rixnobis/ps1-fx3-cart/schematic.pdf

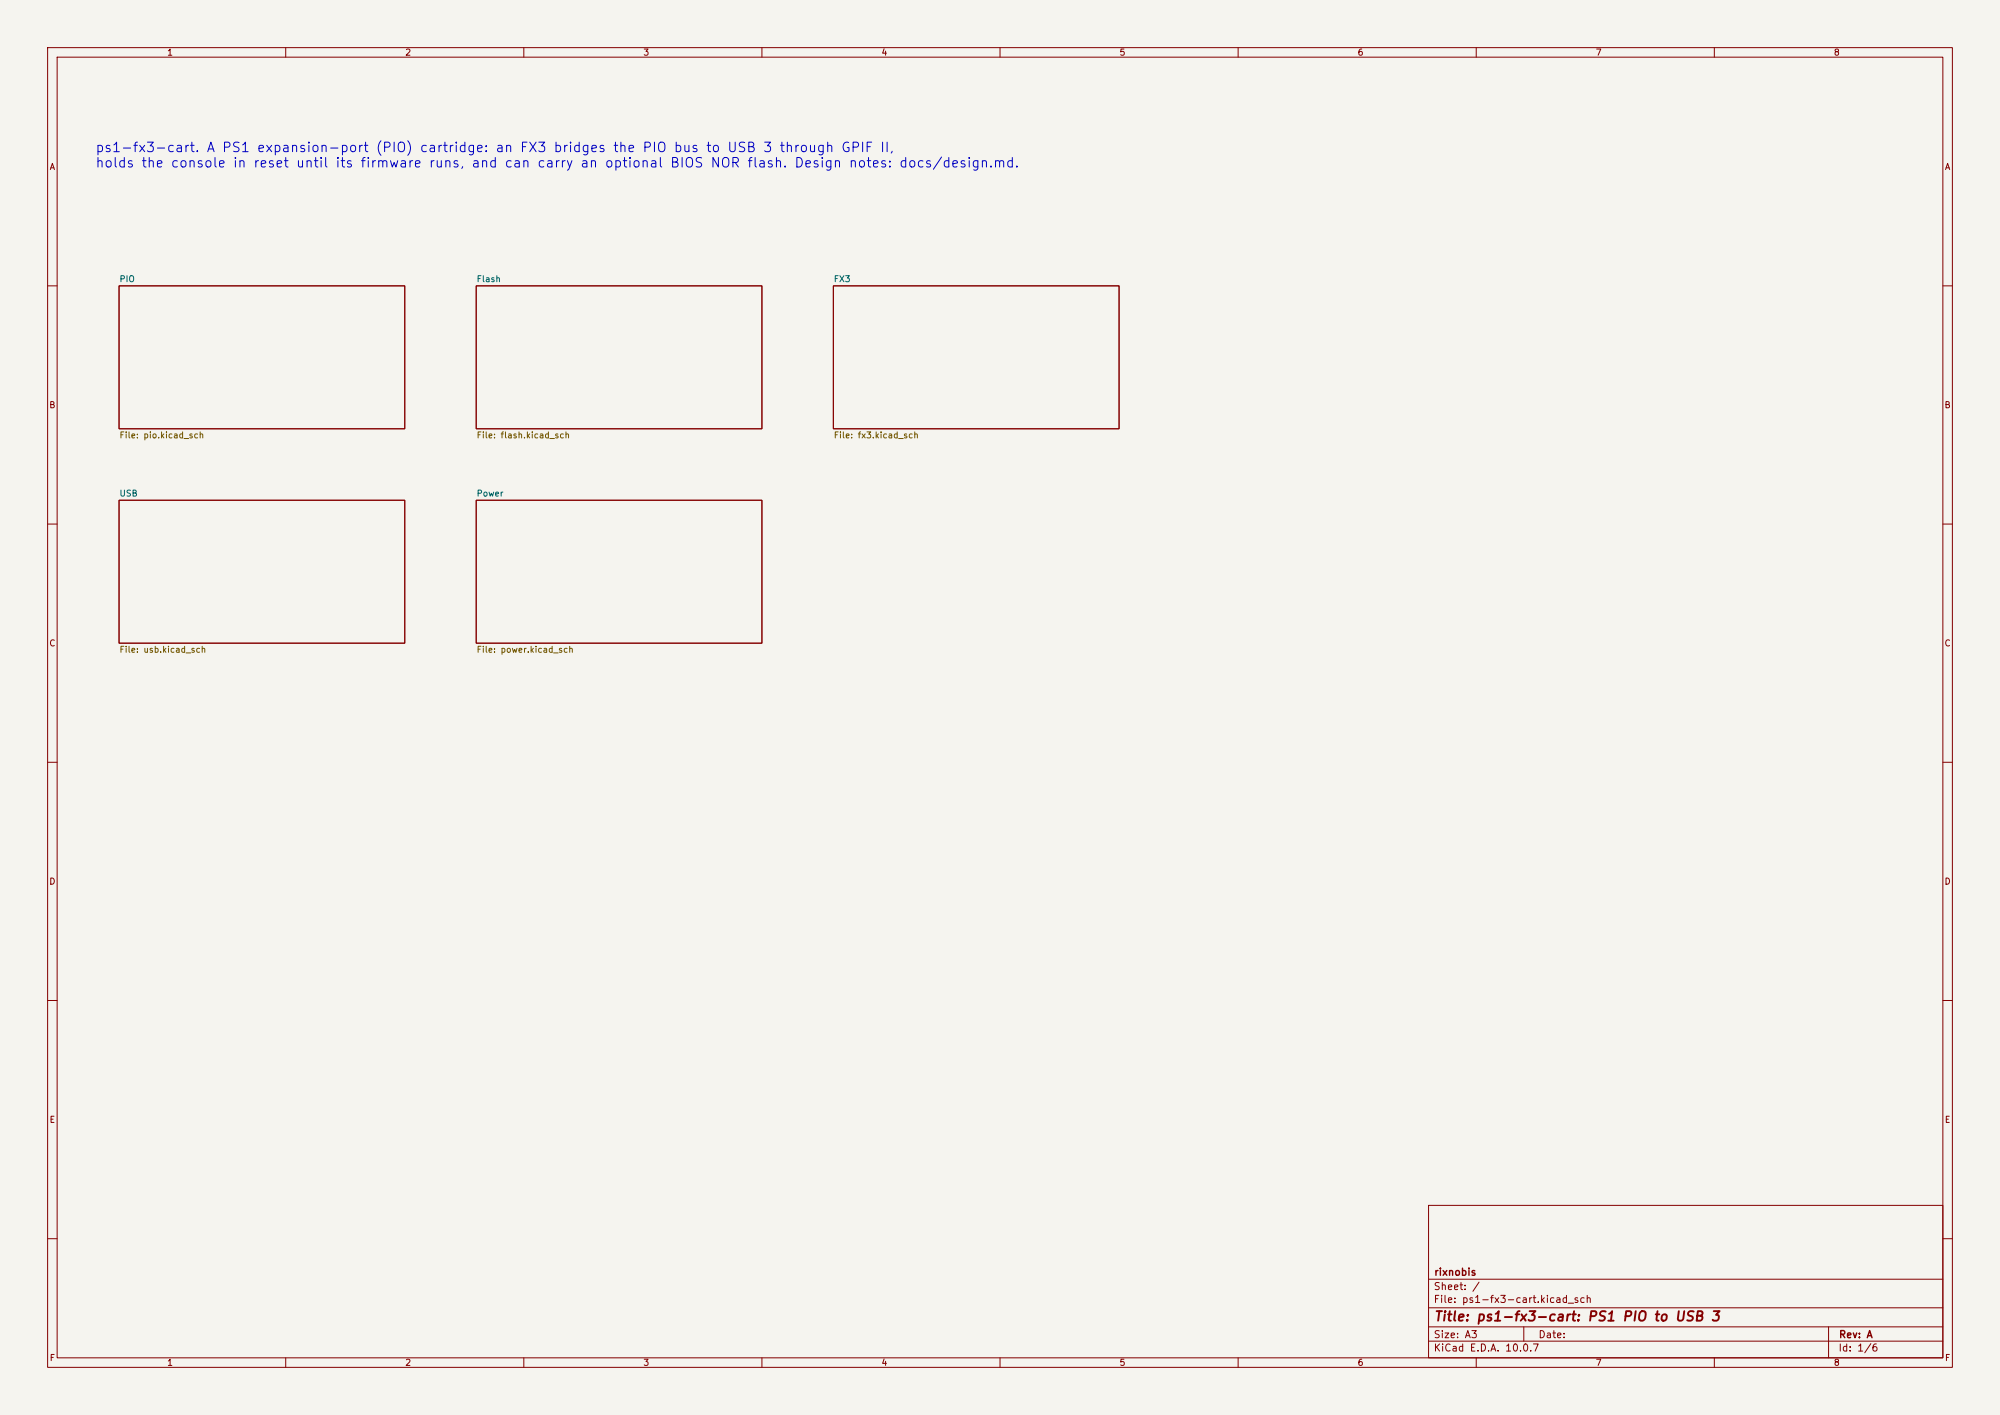
[picture p1: page 1]

ps1-fx3-cart. A PS1 expansion-port (PIO) cartridge: an FX3 bridges the PIO bus to USB 3 through GPIF II,
holds the console in reset until its firmware runs, and can carry an optional BIOS NOR flash. Design notes: docs/design.md.

rixnobis
Sheet: /
File: ps1-fx3-cart.kicad_sch
Title: ps1-fx3-cart: PS1 PIO to USB 3

Size: A3 | Rev: A | F Date:
KiCad E.D.A. 10.0.7 | Id: 1/6

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
## Title: PIO connector, reset hold, defaults

File: pio.kicad_sch

Sheet: /PIO/

rixnobis

GND 1 | RESET 2 | DREQ5 3 | CS0 4
SBEN 5 | D0 6 | D2 7 | D4 8 | D6 9 | D8 10 | D10 11 | D12 12 | D14 13

A0 14
A2 15 | GND 16 | +3.3V 17 | +7.5V 18 | GND 19

A4 20
A6 21
A8 22
A10 23
A12 24
A14 25
A16 26
A18 27
A20 28
A22 29 RD 30

IRQ2 31

SYSCLK1 32 | BCLK 33 | GND 34 | GND | 35 DACK5 | 36
IRQ10 | 37 WR1 | 38 CS2 | 39 D1 | 40 D3 | 41 D5 | 42 D7 | 43 D9 | 44 D11 | 45 D13 | 46 D15 | 47
A1 | | | | | 48
A3 | 49 GND | 50 +3.3V | 51 +7.5V | 52 GND | 53
A5 | | | 54
A7 | | | 55
A9 | | | 56
A11 | | | 57
A13 | | | 58
A15 | | | 59
A17 | | | 60
A19 | | | 61
A21 | | | 62
A23 | 63 WR0 | 64 CS5 | 65
LRCK | | 66
SDIN | 67 GND | 68

### J1PIO

R1
1 | 1k 2 3 | Q1
2N7002 | R2
1k R4

1k R3
1kR5
10k | R7
10k | R8

10k R6
10k
PIO_A2 | PIO_A13 PIO_A11 PIO_A9 PIO_A7 GND

GND

PIO_A5 GND

PIO_I2S_LRCK

# PIO_CS5n PIO_WR0n PIO_WR1n GND

PIO_A0 | PIO_D9 PIO_D1 PIO_D7 PIO_D5 PIO_D8 PIO_D6 PIO_D4 PIO_D2 PIO_D0 | PIO_D3 | PIO_SBEN PIO_IN2n | PIO_DREQ5 GND +3V3 GND | +3V3 PIO_SBEN | PIO_INT10n PIO_CS2n_SENSE PIO_CS2n | GND | PIO_SBEN_DRV
PIO_A15 | RST_SENSE GND | +3V3 RST_HOLD | PIO_RESETn PIO_RESETn RST_HOLD
PIO_RESETn | PIO_DACK5 PIO_I2S_SDIN

PIO_A19 PIO_A17 PIO_A8 PIO_A20 +3V3 PIO_A18 GND

PIO_A16 PIO_A14 PIO_A12 PIO_D10 PIO_A10 PIO_D12 PIO_D14 PIO_DREQ5 | PIO_CS2n PIO_A6 | PIO_D11 PIO_D13 PIO_D15 PIO_A4 PIO_RDn PIO_IN2n PIO_SYSCLK1 PIO_I2S_BCLK

GND

GND

PIO_A1 +3V3 PIO_SBEN

PIO_A3 PIO_INT10n PIO_CS0n | Reset hold: Q1 pulls PIO /RESET low while its gate is high. The gate pin GPIO33 is
tristated by the boot ROM (AN76405 Table 30), so the 1k pull-up holds the console in reset until FX3 firmware drives GPIO33 low. Sizing: the FX3 can put a 10k pull-down on any pin (datasheet I/O states), and AN76405 does not say the boot ROM's tristate excludes it; 1k against 10k still gives 3.3 V x 10/11 = 3.0 V on the gate, above the 2N7002's 2.5 V maximum VGS(th). Released, GPIO33 sinks 3.3 mA, under the IOL of quarter drive (3.96 mA even at VIO 2.5 V, datasheet Table 9). GPIO34 senses /RESET through 1k: 3.3 mA at most if it is ever driven as an output, and an internal 10k pull-down still reads high (3.0 V).

Defaults while the FX3 is unconfigured: SBEN low (no Switch Board takeover), /IRQ10 and /IRQ2 high (inactive), DREQ5 low (inactive; DREQ/DACK are active high).

/CS2 sense: GPIO39 reads pin 39 through 1k. Pin 39 is GND on a stock console, so GPIO39 misdriven high sinks 3.3 mA instead of shorting the pin. SBEN drive: GPIO37 reaches pin 5 through 1k. Pin 5 is GND on a stock console, so GPIO37 driven high sinks 3.3 mA instead of shorting the pin.

PIO expansion port (CN103), pin numbers as psx-spx (console rear view). On a stock console pin 5 (SBEN) and pin 39 (/CS2) are GND and pins 31/65 are NC; they carry SBEN, /CS2, /IRQ2 and /CS5 only with a Switch Board mod. The 3.3 V pins feed the whole cart; 7.5 V and A21-A23 are unused.

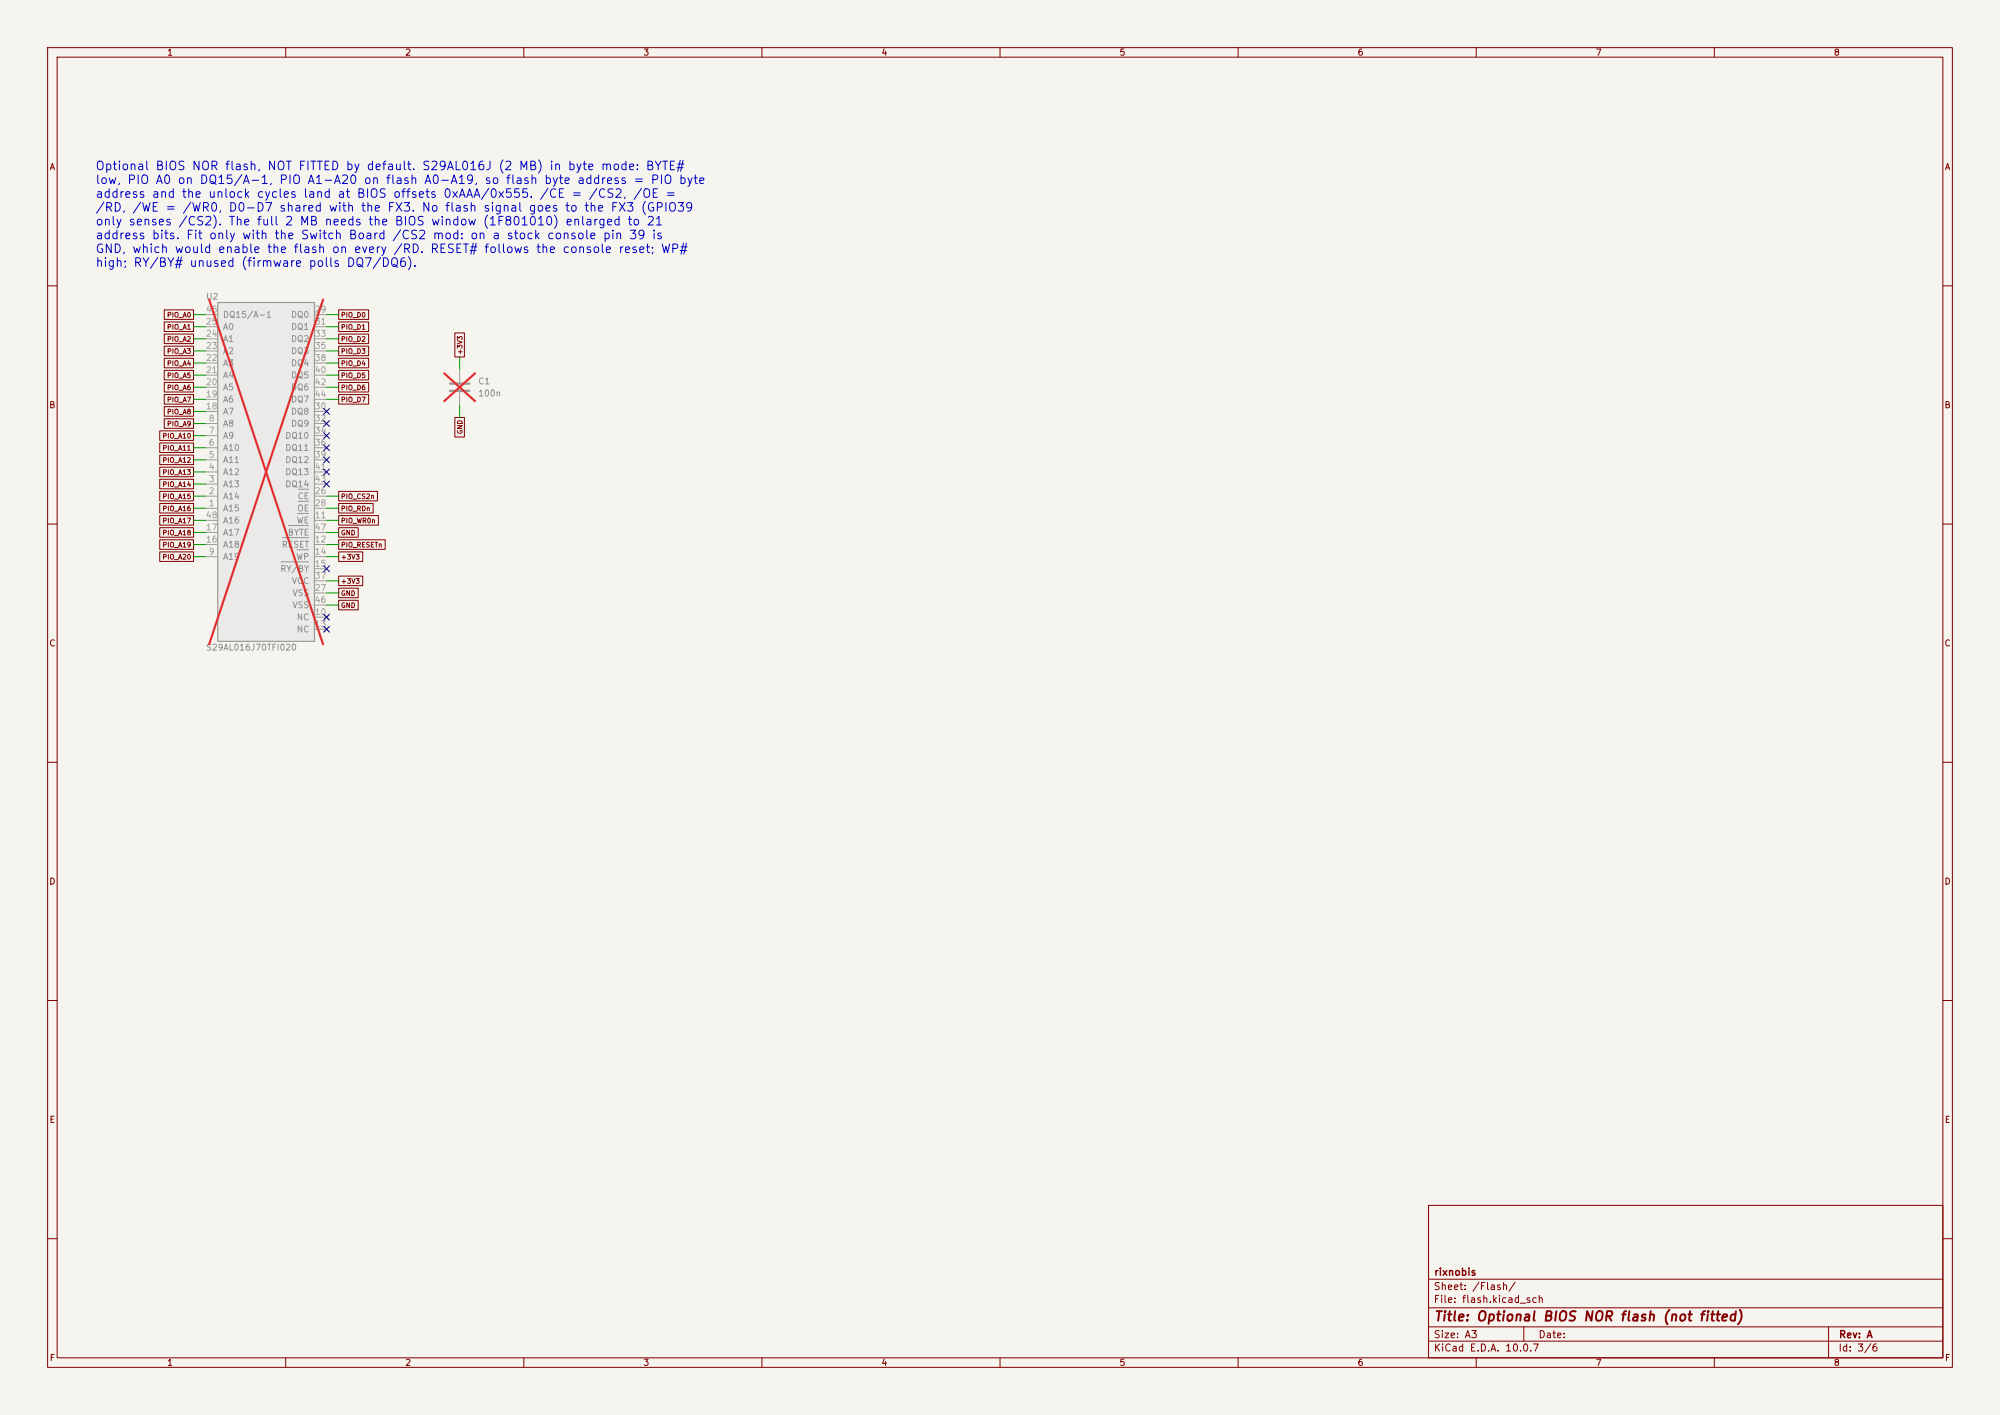
[picture p2: page 3]

Optional BIOS NOR flash, NOT FITTED by default. S29AL016J (2 MB) in byte mode: BYTE#
low, PIO A0 on DQ15/A-1, PIO A1-A20 on flash A0-A19, so flash byte address = PIO byte
address and the unlock cycles land at BIOS offsets 0xAAA/0x555. /CE = /CS2, /OE =
/RD, /WE = /WR0, D0-D7 shared with the FX3. No flash signal goes to the FX3 (GPIO39
only senses /CS2). The full 2 MB needs the BIOS window (1F801010) enlarged to 21
address bits. Fit only with the Switch Board /CS2 mod: on a stock console pin 39 is
GND, which would enable the flash on every /RD. RESET# follows the console reset; WP#
high; RY/BY# unused (firmware polls DQ7/DQ6).

rixnobis
Sheet: /Flash/
File: flash.kicad_sch
Title: Optional BIOS NOR flash (not fitted)

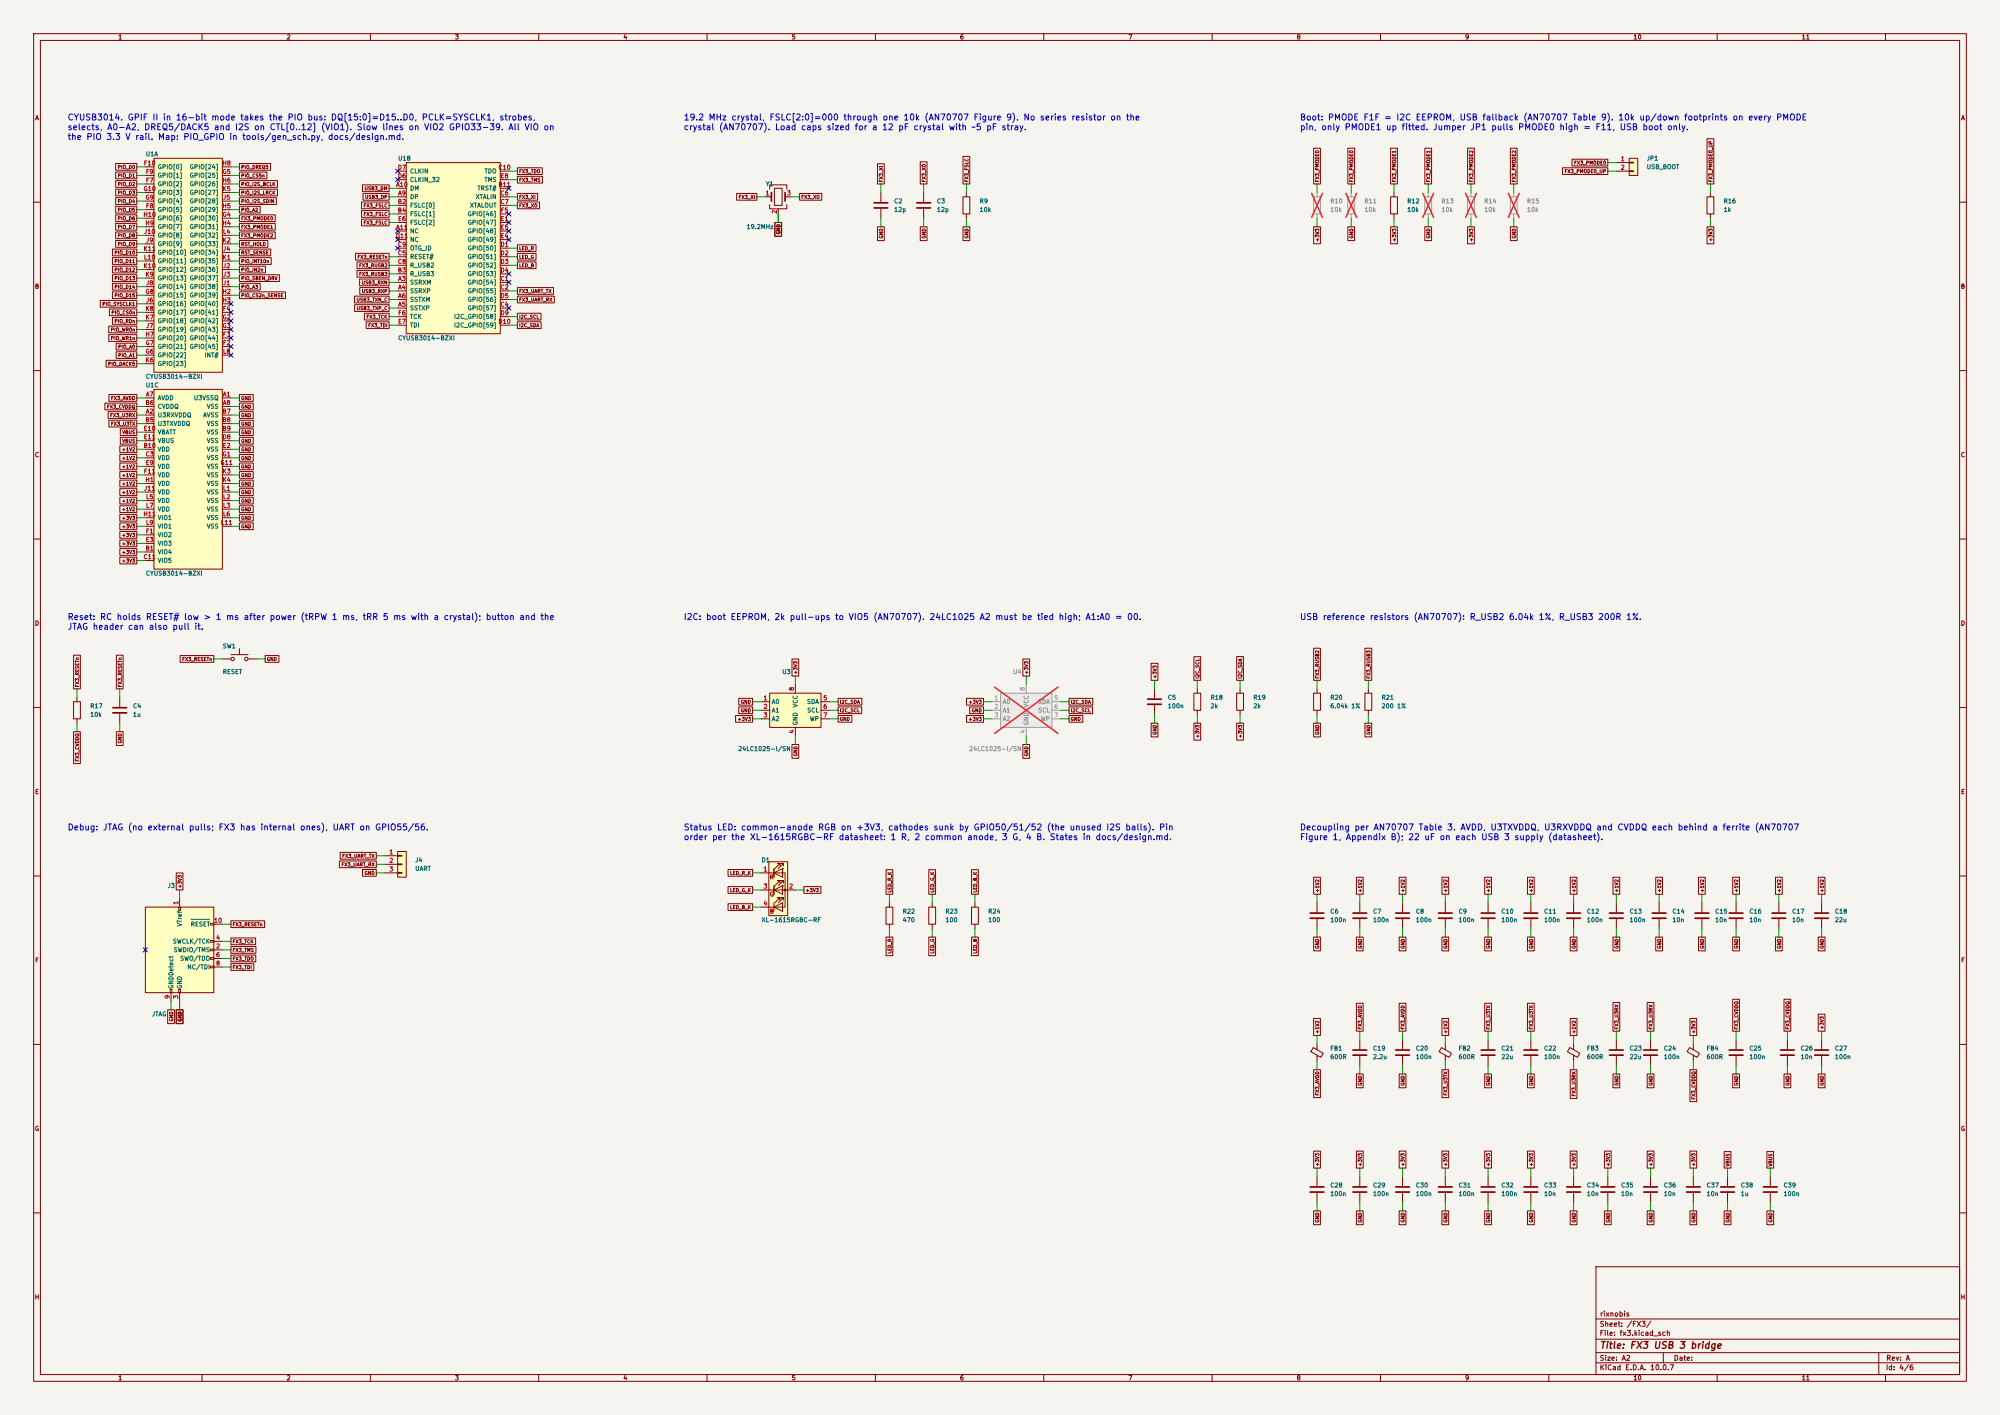
[picture p3: page 4]

CYUSB3014. GPIF II in 16-bit mode takes the PIO bus: DQ[15:0]=D15..D0, PCLK=SYSCLK1, strobes,
selects, A0-A2, DREQ5/DACK5 and I2S on CTL[0..12] (VIO1). Slow lines on VIO2 GPIO33-39. All VIO on
the PIO 3.3 V rail. Map: PIO_GPIO in tools/gen_sch.py, docs/design.md.

19.2 MHz crystal, FSLC[2:0]=000 through one 10k (AN70707 Figure 9). No series resistor on the
crystal (AN70707). Load caps sized for a 12 pF crystal with ~5 pF stray.

Boot: PMODE F1F = I2C EEPROM, USB fallback (AN70707 Table 9). 10k up/down footprints on every PMODE
pin, only PMODE1 up fitted. Jumper JP1 pulls PMODE0 high = F11, USB boot only.
FX3_PMODE0 GND

+3V3 PIO_D15 PIO_D14 Reset: RC holds RESET# low > 1 ms after power (tRPW 1 ms, tRR 5 ms with a crystal); button and the

I2C: boot EEPROM, 2k pull-ups to VIO5 (AN70707). 24LC1025 A2 must be tied high; A1:A0 = 00.

JTAG header can also pull it.

Debug: JTAG (no external pulls; FX3 has internal ones), UART on GPIO55/56.

Status LED: common-anode RGB on +3V3, cathodes sunk by GPIO50/51/52 (the unused I2S balls). Pin
order per the XL-1615RGBC-RF datasheet: 1 R, 2 common anode, 3 G, 4 B. States in docs/design.md.

Decoupling per AN70707 Table 3. AVDD, U3TXVDDQ, U3RXVDDQ and CVDDQ each behind a ferrite (AN70707
Figure 1, Appendix B); 22 uF on each USB 3 supply (datasheet).

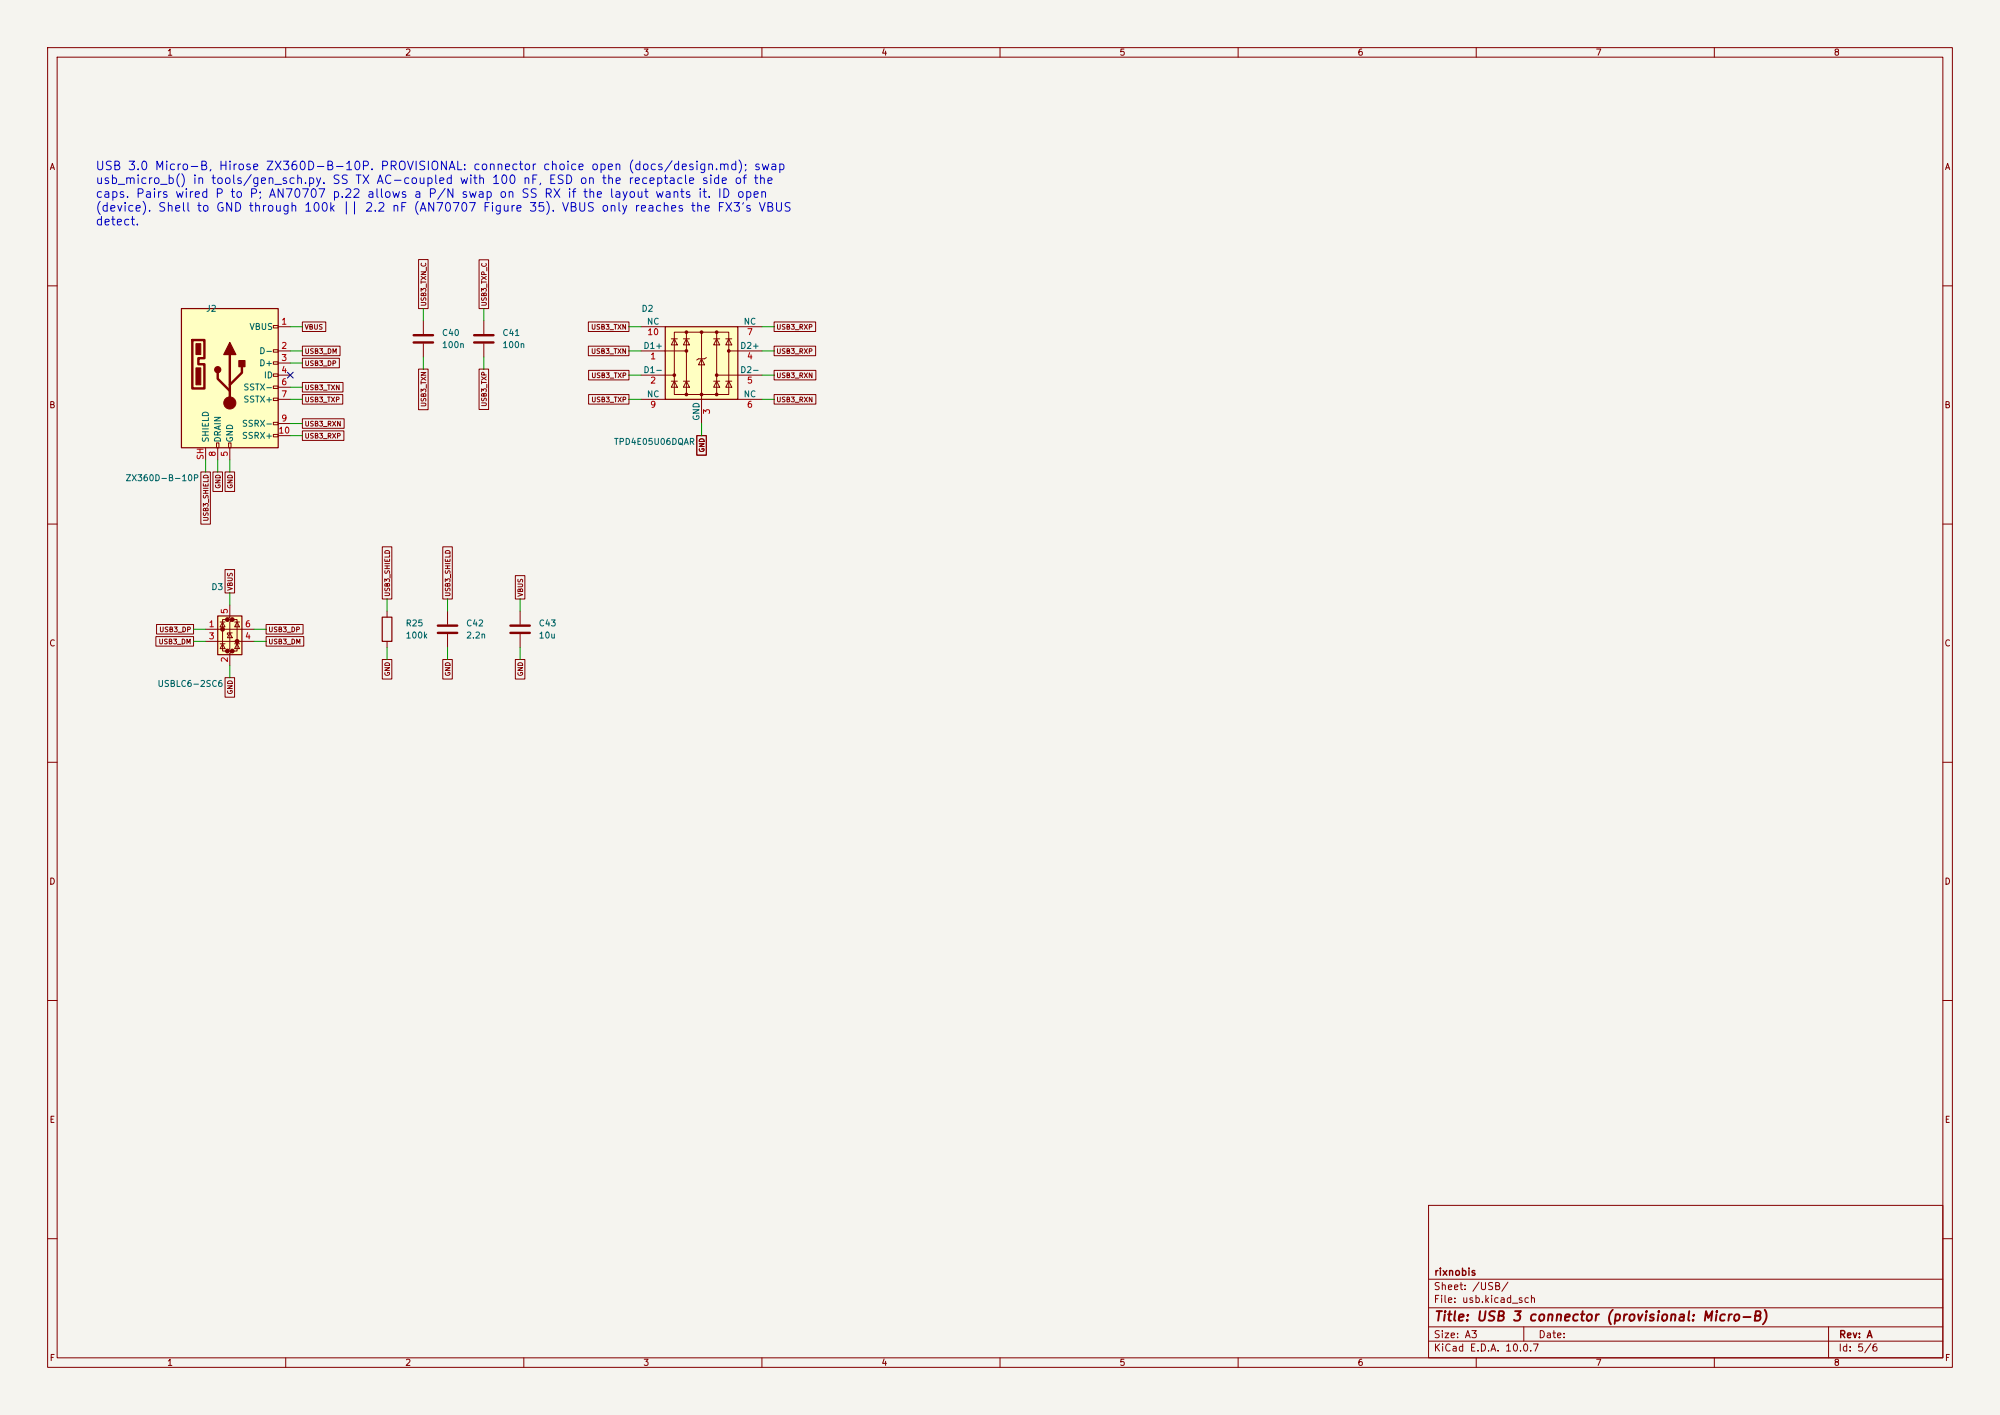
[picture p4: page 5]

USB 3.0 Micro-B, Hirose ZX360D-B-10P. PROVISIONAL: connector choice open (docs/design.md); swap
usb_micro_b() in tools/gen_sch.py. SS TX AC-coupled with 100 nF, ESD on the receptacle side of the
caps. Pairs wired P to P; AN70707 p.22 allows a P/N swap on SS RX if the layout wants it. ID open
(device). Shell to GND through 100k || 2.2 nF (AN70707 Figure 35). VBUS only reaches the FX3's VBUS
detect.

rixnobis
Sheet: /USB/
File: usb.kicad_sch
Title: USB 3 connector (provisional: Micro-B)

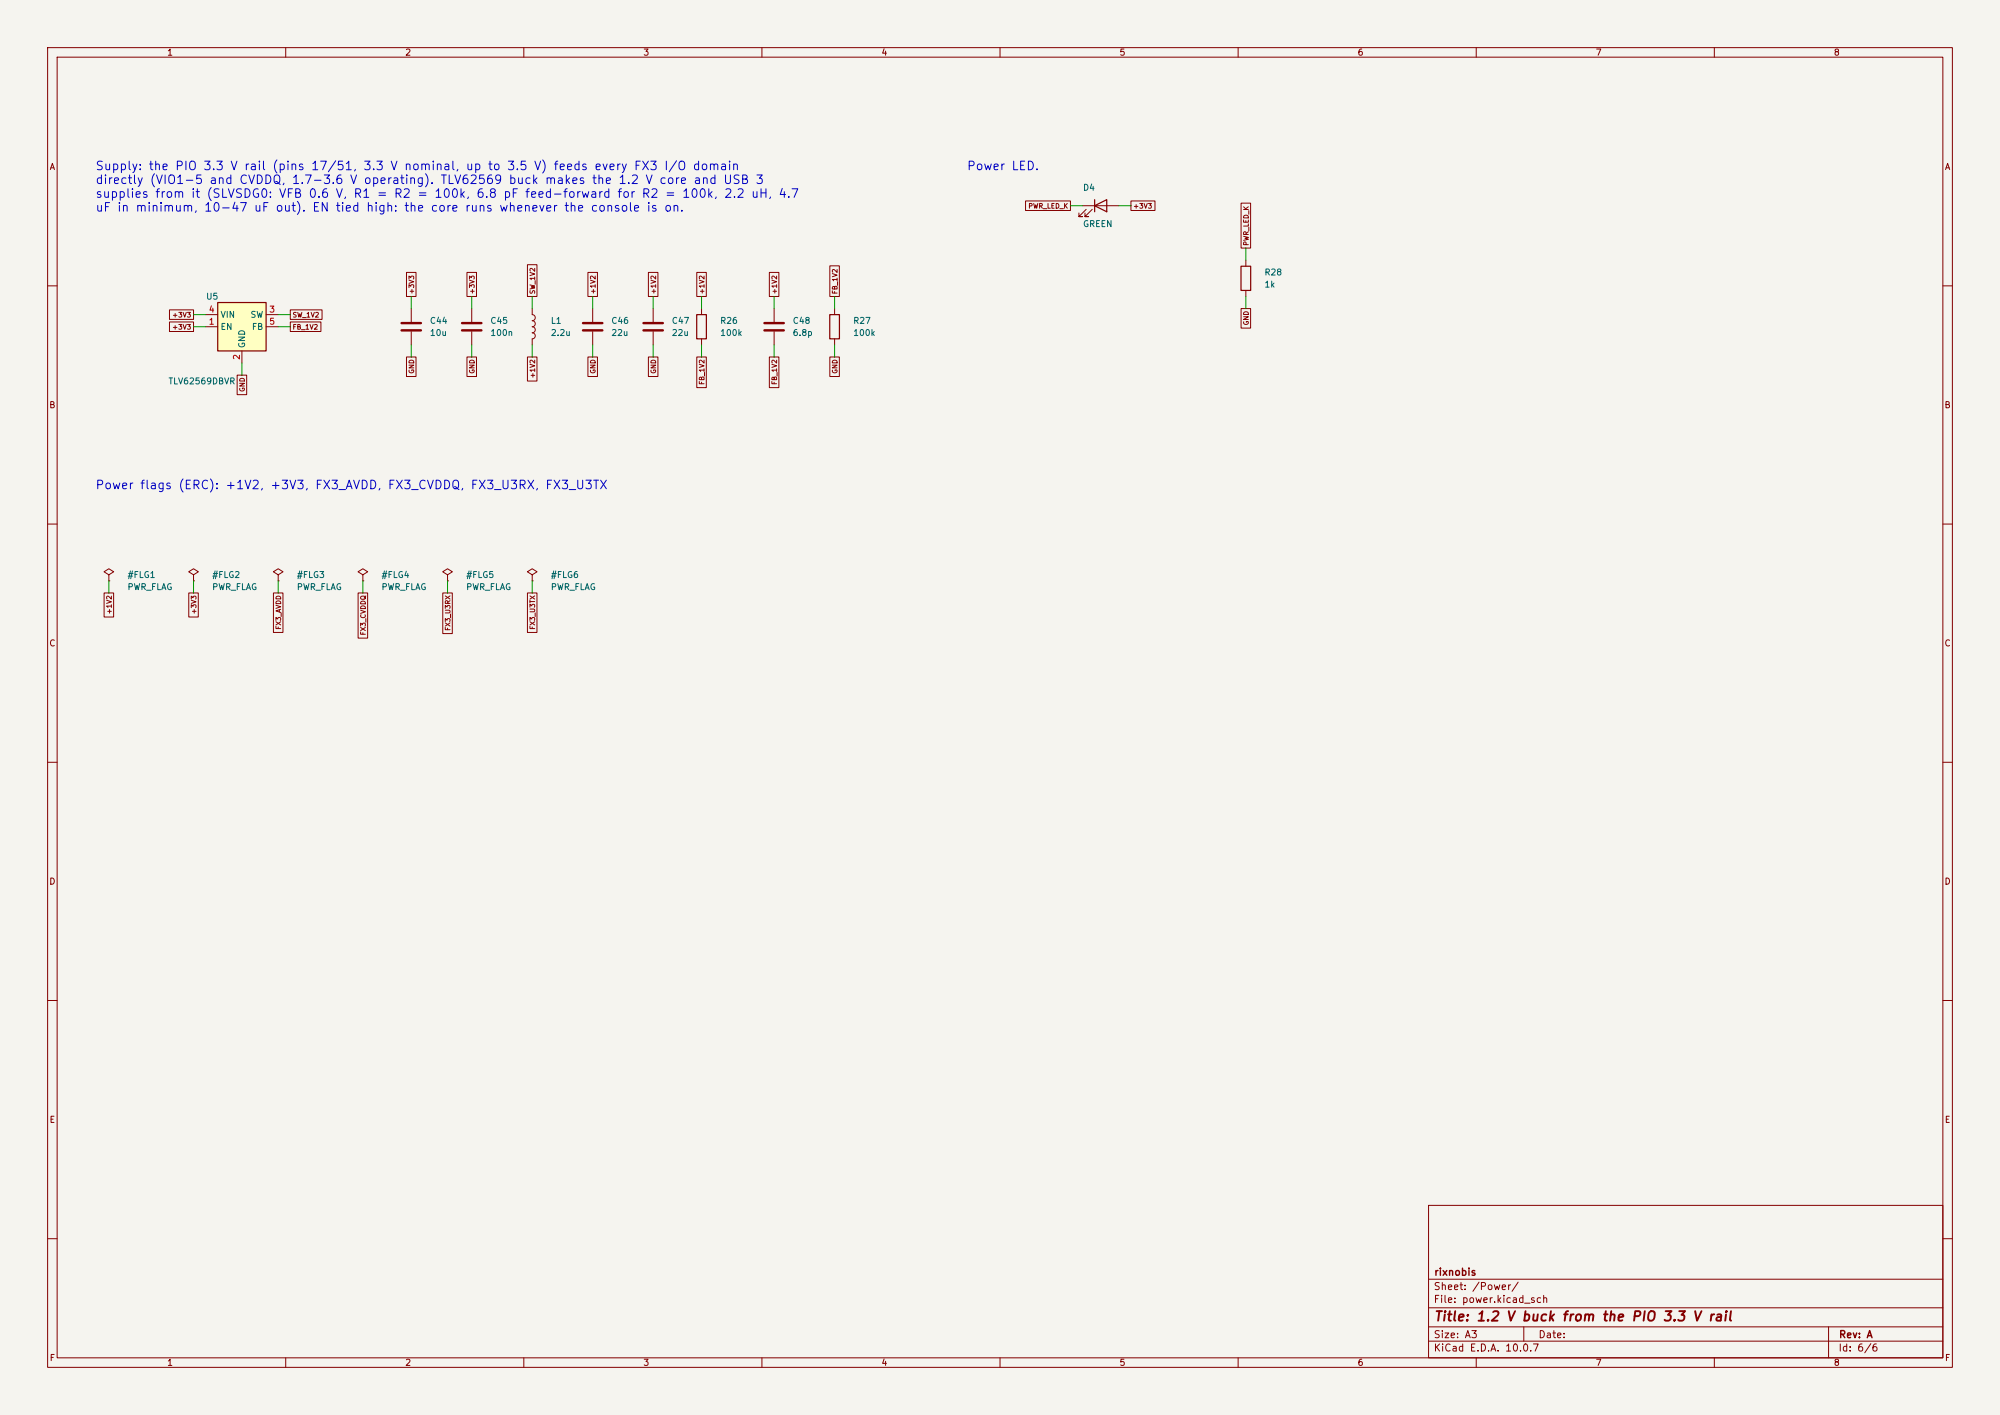
[picture p5: page 6]

directly (VIO1-5 and CVDDQ, 1.7-3.6 V operating). TLV62569 buck makes the 1.2 V core and USB 3
supplies from it (SLVSDG0: VFB 0.6 V, R1 = R2 = 100k, 6.8 pF feed-forward for R2 = 100k, 2.2 uH, 4.7
uF in minimum, 10-47 uF out). EN tied high: the core runs whenever the console is on.

rixnobis
Sheet: /Power/
File: power.kicad_sch
Title: 1.2 V buck from the PIO 3.3 V rail
