rixnobis/ps1-fx3-cart/ps1-fx3-cart.kicad_pcb

## KiCad design ps1-fx3-cart.kicad_pcb (2026-10-28)

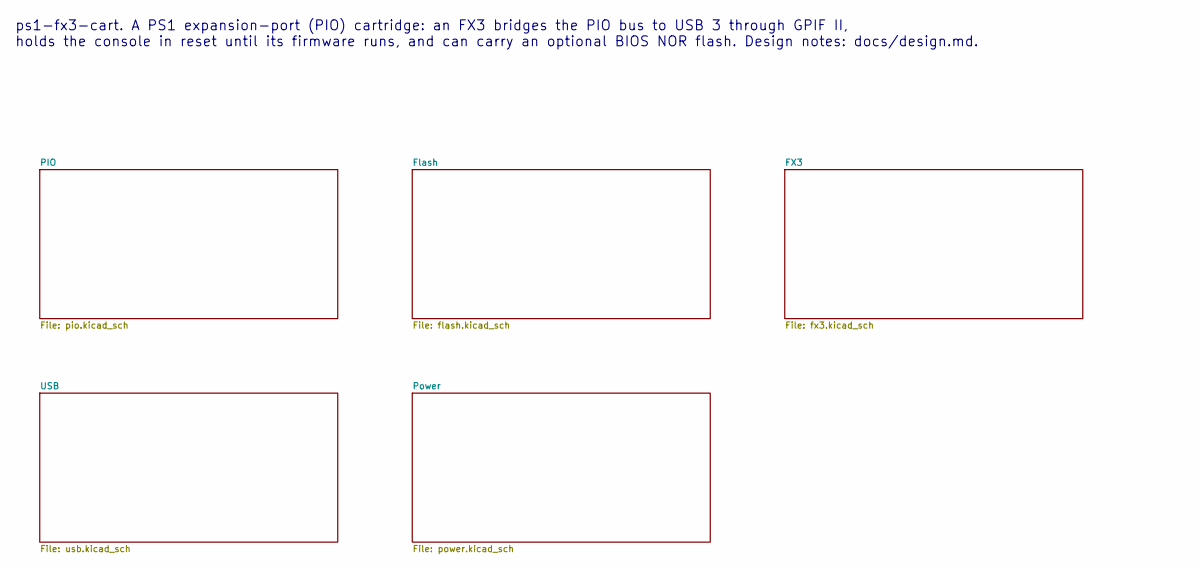
[picture p6: schematic ps1-fx3-cart.kicad_sch, ps1-fx3-cart: PS1 PIO to USB 3]

Notes on the sheet:
ps1-fx3-cart. A PS1 expansion-port (PIO) cartridge: an FX3 bridges the PIO bus to USB 3 through GPIF II, holds the console in reset until its firmware runs, and can carry an optional BIOS NOR flash. Design notes: docs/design.md.

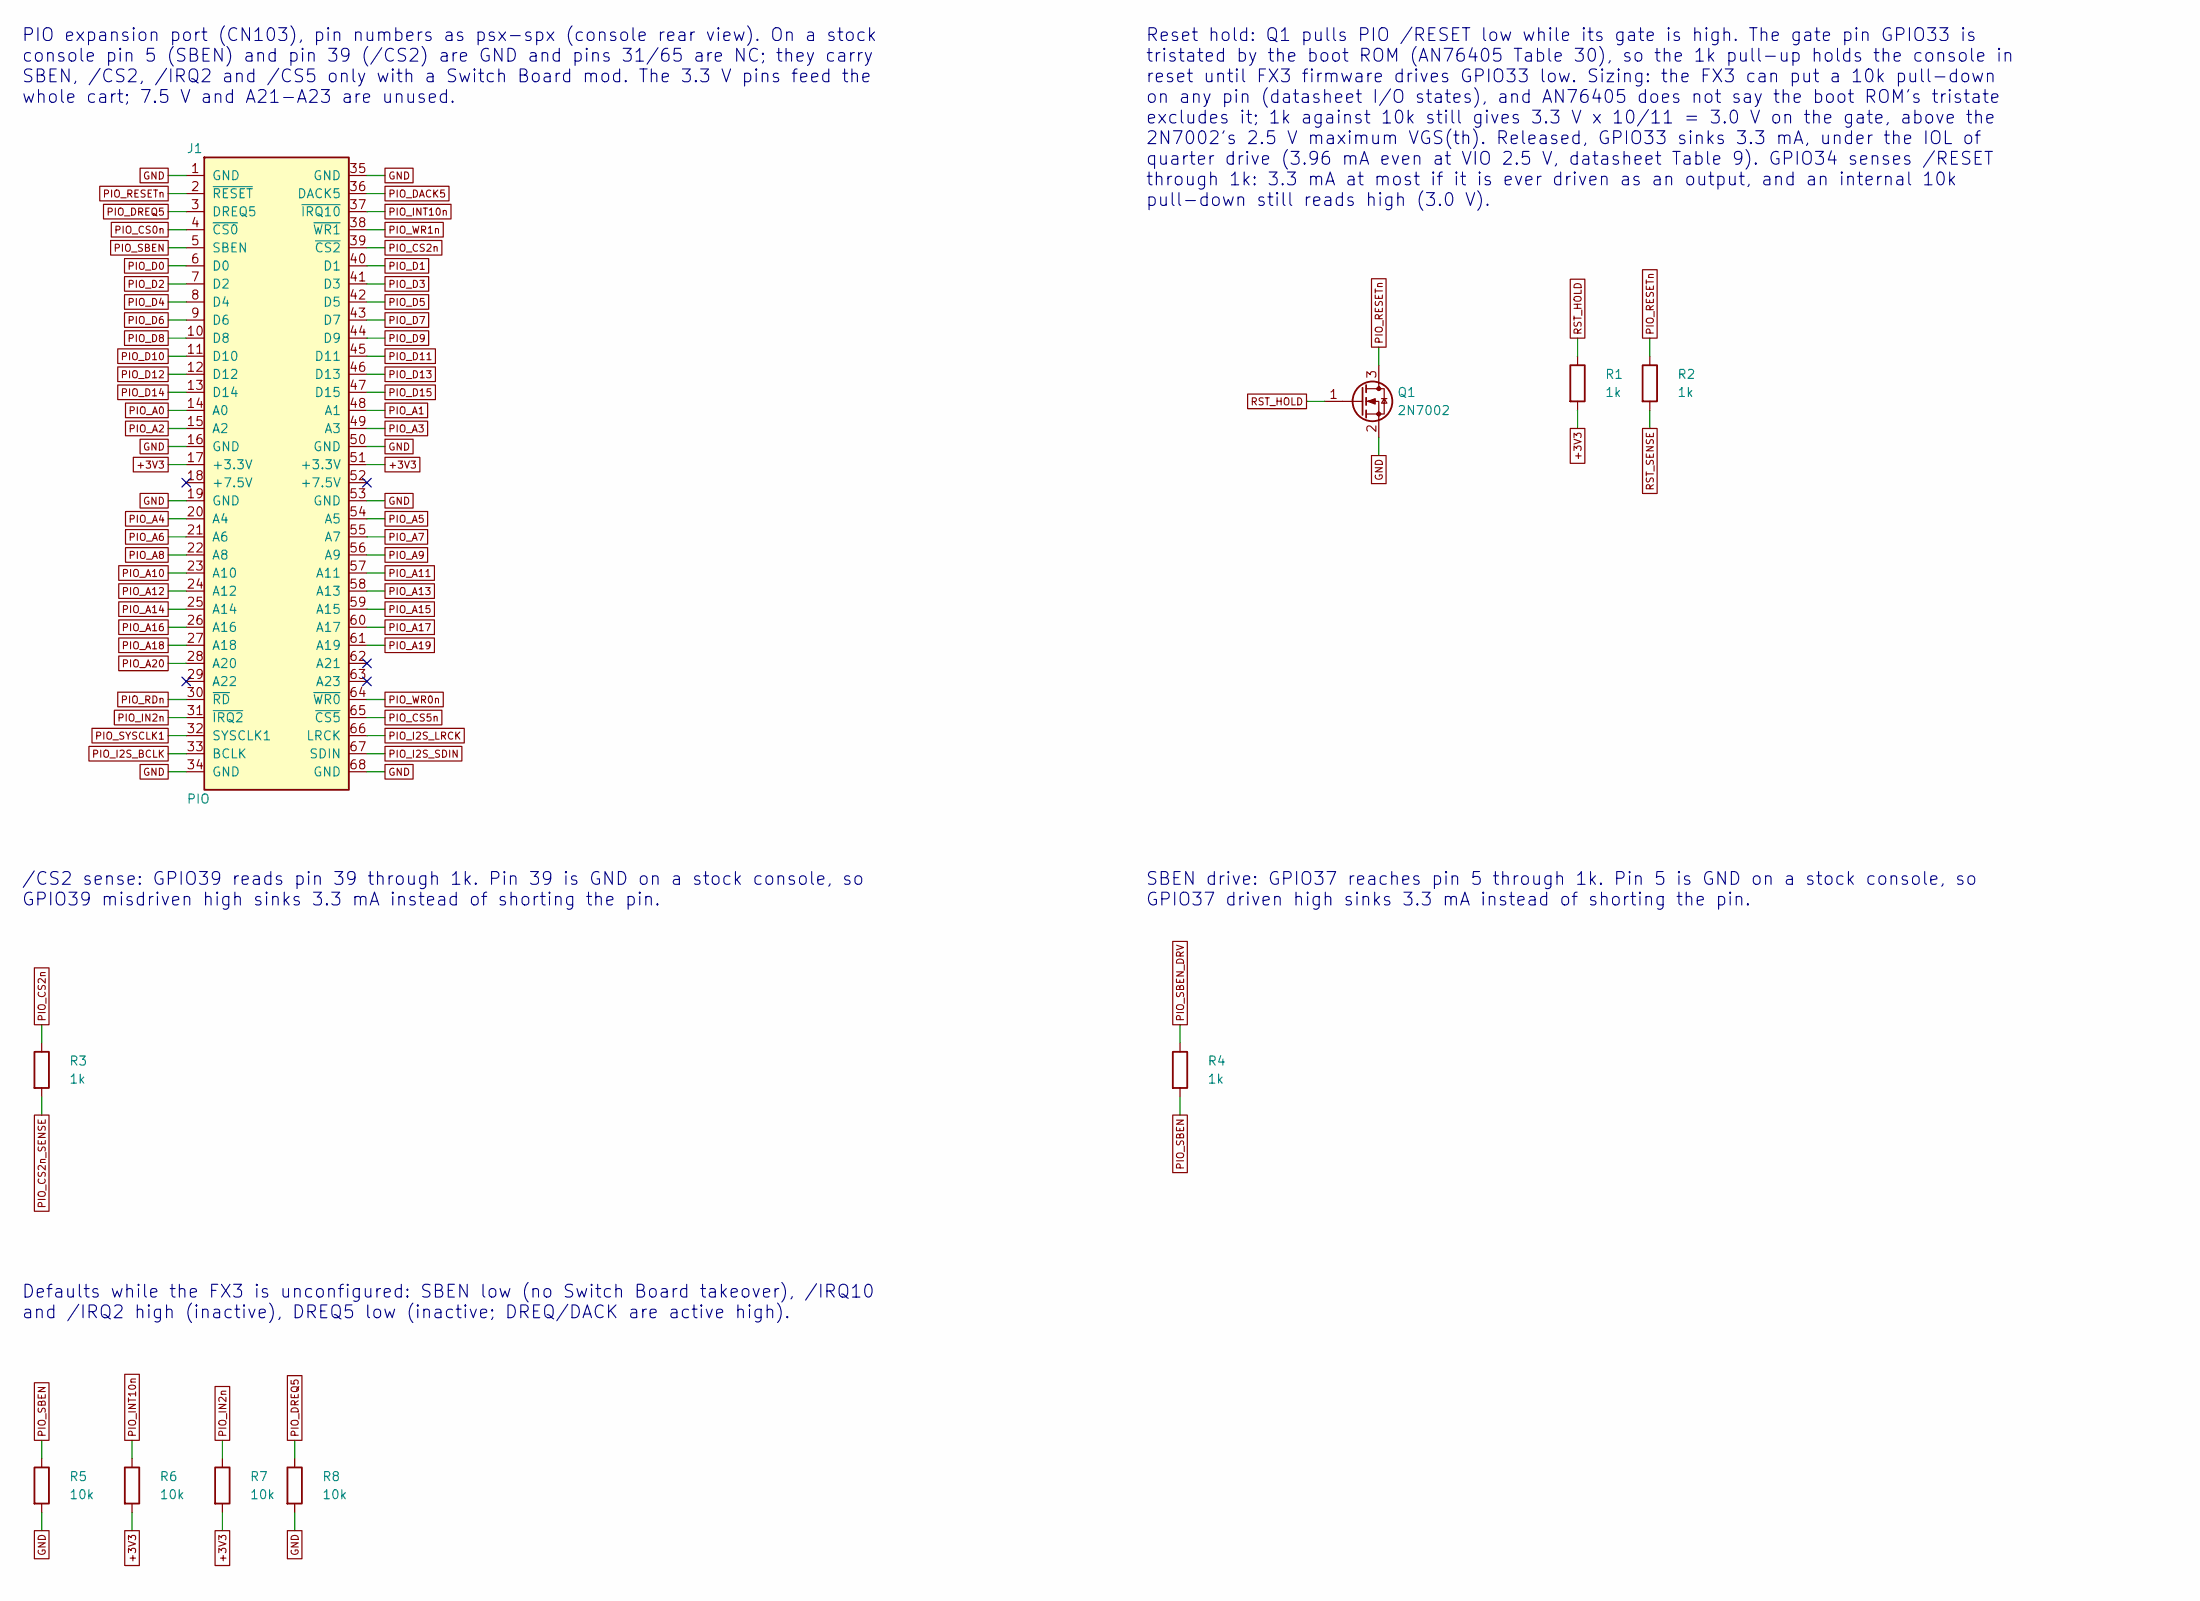
[picture p7: schematic pio.kicad_sch, PIO connector, reset hold, defaults]

Parts:
J1: PIO; PIOCONN
Q1: 2N7002; SOT-23; LCSC C8545
R1, R2, R3, R4: 1k; R_0402_1005Metric; LCSC C11702
R5, R6, R7, R8: 10k; R_0402_1005Metric; LCSC C25744

Connections:
+3V3: J1.17 (+3.3V), J1.51 (+3.3V), R1.2, R6.2, R7.2; also elsewhere on the board
GND: J1.1 (GND), J1.16 (GND), J1.19 (GND), J1.34 (GND), J1.35 (GND), J1.50 (GND), J1.53 (GND), J1.68 (GND), Q1.2 (S), R5.2, R8.2; also elsewhere on the board
PIO_A0: J1.14 (A0); also elsewhere on the board
PIO_A1: J1.48 (A1); also elsewhere on the board
PIO_A2: J1.15 (A2); also elsewhere on the board
PIO_A3: J1.49 (A3); also elsewhere on the board
PIO_A4: J1.20 (A4); also elsewhere on the board
PIO_A5: J1.54 (A5); also elsewhere on the board
PIO_A6: J1.21 (A6); also elsewhere on the board
PIO_A7: J1.55 (A7); also elsewhere on the board
PIO_A8: J1.22 (A8); also elsewhere on the board
PIO_A9: J1.56 (A9); also elsewhere on the board
PIO_A10: J1.23 (A10); also elsewhere on the board
PIO_A11: J1.57 (A11); also elsewhere on the board
PIO_A12: J1.24 (A12); also elsewhere on the board
PIO_A13: J1.58 (A13); also elsewhere on the board
PIO_A14: J1.25 (A14); also elsewhere on the board
PIO_A15: J1.59 (A15); also elsewhere on the board
PIO_A16: J1.26 (A16); also elsewhere on the board
PIO_A17: J1.60 (A17); also elsewhere on the board
PIO_A18: J1.27 (A18); also elsewhere on the board
PIO_A19: J1.61 (A19); also elsewhere on the board
PIO_A20: J1.28 (A20); also elsewhere on the board
PIO_CS0n: J1.4 (~CS0); also elsewhere on the board
PIO_CS2n: J1.39 (~CS2), R3.1; also elsewhere on the board
PIO_CS2n_SENSE: R3.2; also elsewhere on the board
PIO_CS5n: J1.65 (~CS5); also elsewhere on the board
PIO_D0: J1.6 (D0); also elsewhere on the board
PIO_D1: J1.40 (D1); also elsewhere on the board
PIO_D2: J1.7 (D2); also elsewhere on the board
PIO_D3: J1.41 (D3); also elsewhere on the board
PIO_D4: J1.8 (D4); also elsewhere on the board
PIO_D5: J1.42 (D5); also elsewhere on the board
PIO_D6: J1.9 (D6); also elsewhere on the board
PIO_D7: J1.43 (D7); also elsewhere on the board
PIO_D8: J1.10 (D8); also elsewhere on the board
PIO_D9: J1.44 (D9); also elsewhere on the board
PIO_D10: J1.11 (D10); also elsewhere on the board
PIO_D11: J1.45 (D11); also elsewhere on the board
PIO_D12: J1.12 (D12); also elsewhere on the board
PIO_D13: J1.46 (D13); also elsewhere on the board
PIO_D14: J1.13 (D14); also elsewhere on the board
PIO_D15: J1.47 (D15); also elsewhere on the board
PIO_DACK5: J1.36 (DACK5); also elsewhere on the board
PIO_DREQ5: J1.3 (DREQ5), R8.1; also elsewhere on the board
PIO_I2S_BCLK: J1.33 (BCLK); also elsewhere on the board
PIO_I2S_LRCK: J1.66 (LRCK); also elsewhere on the board
PIO_I2S_SDIN: J1.67 (SDIN); also elsewhere on the board
PIO_IN2n: J1.31 (~IRQ2), R7.1; also elsewhere on the board
PIO_INT10n: J1.37 (~IRQ10), R6.1; also elsewhere on the board
PIO_RDn: J1.30 (~RD); also elsewhere on the board
PIO_RESETn: J1.2 (~RESET), Q1.3 (D), R2.1; also elsewhere on the board
PIO_SBEN: J1.5 (SBEN), R4.2, R5.1
PIO_SBEN_DRV: R4.1; also elsewhere on the board
PIO_SYSCLK1: J1.32 (SYSCLK1); also elsewhere on the board
PIO_WR0n: J1.64 (~WR0); also elsewhere on the board
PIO_WR1n: J1.38 (~WR1); also elsewhere on the board
RST_HOLD: Q1.1 (G), R1.1; also elsewhere on the board
RST_SENSE: R2.2; also elsewhere on the board

Notes on the sheet:
PIO expansion port (CN103), pin numbers as psx-spx (console rear view). On a stock console pin 5 (SBEN) and pin 39 (/CS2) are GND and pins 31/65 are NC; they carry SBEN, /CS2, /IRQ2 and /CS5 only with a Switch Board mod. The 3.3 V pins feed the whole cart; 7.5 V and A21-A23 are unused.
Reset hold: Q1 pulls PIO /RESET low while its gate is high. The gate pin GPIO33 is tristated by the boot ROM (AN76405 Table 30), so the 1k pull-up holds the console in reset until FX3 firmware drives GPIO33 low. Sizing: the FX3 can put a 10k pull-down on any pin (datasheet I/O states), and AN76405 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
/CS2 sense: GPIO39 reads pin 39 through 1k. Pin 39 is GND on a stock console, so GPIO39 misdriven high sinks 3.3 mA instead of shorting the pin.
SBEN drive: GPIO37 reaches pin 5 through 1k. Pin 5 is GND on a stock console, so GPIO37 driven high sinks 3.3 mA instead of shorting the pin.
Defaults while the FX3 is unconfigured: SBEN low (no Switch Board takeover), /IRQ10 and /IRQ2 high (inactive), DREQ5 low (inactive; DREQ/DACK are active high).

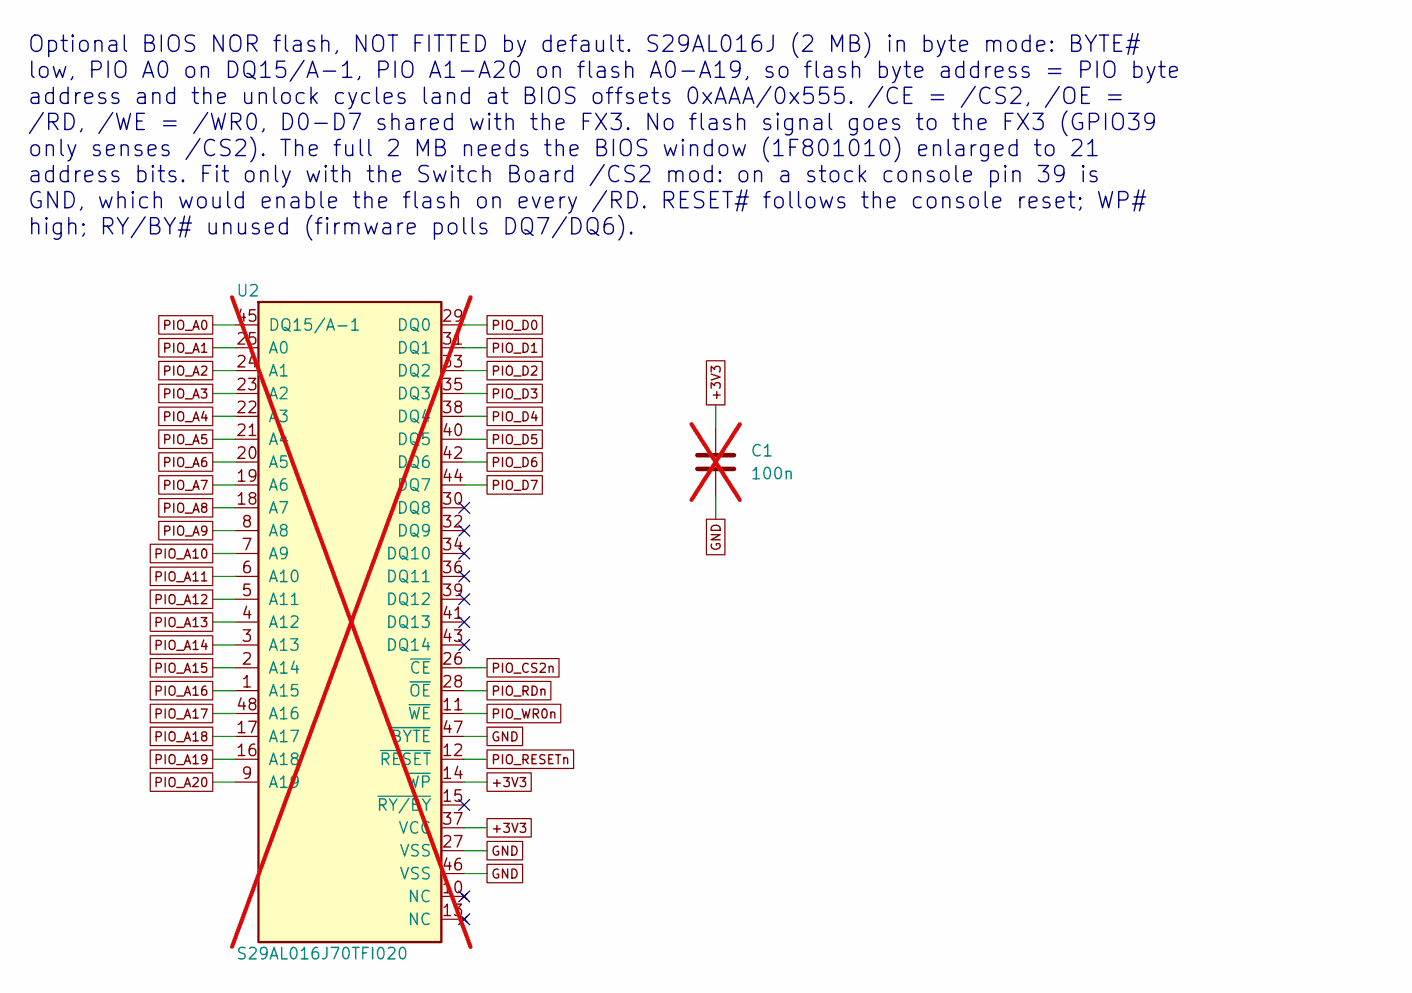
[picture p8: schematic flash.kicad_sch, Optional BIOS NOR flash (not fitted)]

Parts:
C1: 100n; C_0402_1005Metric; LCSC C1525; not fitted
U2: S29AL016J70TFI020; TSOP-I-48_18.4x12mm_P0.5mm; LCSC C914935; not fitted

Connections:
+3V3: C1.1, U2.14 (~WP), U2.37 (VCC); also elsewhere on the board
GND: C1.2, U2.27 (VSS), U2.46 (VSS), U2.47 (~BYTE); also elsewhere on the board
PIO_A0: U2.45 (DQ15/A-1); also elsewhere on the board
PIO_A1: U2.25 (A0); also elsewhere on the board
PIO_A2: U2.24 (A1); also elsewhere on the board
PIO_A3: U2.23 (A2); also elsewhere on the board
PIO_A4: U2.22 (A3); also elsewhere on the board
PIO_A5: U2.21 (A4); also elsewhere on the board
PIO_A6: U2.20 (A5); also elsewhere on the board
PIO_A7: U2.19 (A6); also elsewhere on the board
PIO_A8: U2.18 (A7); also elsewhere on the board
PIO_A9: U2.8 (A8); also elsewhere on the board
PIO_A10: U2.7 (A9); also elsewhere on the board
PIO_A11: U2.6 (A10); also elsewhere on the board
PIO_A12: U2.5 (A11); also elsewhere on the board
PIO_A13: U2.4 (A12); also elsewhere on the board
PIO_A14: U2.3 (A13); also elsewhere on the board
PIO_A15: U2.2 (A14); also elsewhere on the board
PIO_A16: U2.1 (A15); also elsewhere on the board
PIO_A17: U2.48 (A16); also elsewhere on the board
PIO_A18: U2.17 (A17); also elsewhere on the board
PIO_A19: U2.16 (A18); also elsewhere on the board
PIO_A20: U2.9 (A19); also elsewhere on the board
PIO_CS2n: U2.26 (~CE); also elsewhere on the board
PIO_D0: U2.29 (DQ0); also elsewhere on the board
PIO_D1: U2.31 (DQ1); also elsewhere on the board
PIO_D2: U2.33 (DQ2); also elsewhere on the board
PIO_D3: U2.35 (DQ3); also elsewhere on the board
PIO_D4: U2.38 (DQ4); also elsewhere on the board
PIO_D5: U2.40 (DQ5); also elsewhere on the board
PIO_D6: U2.42 (DQ6); also elsewhere on the board
PIO_D7: U2.44 (DQ7); also elsewhere on the board
PIO_RDn: U2.28 (~OE); also elsewhere on the board
PIO_RESETn: U2.12 (~RESET); also elsewhere on the board
PIO_WR0n: U2.11 (~WE); also elsewhere on the board

Notes on the sheet:
Optional BIOS NOR flash, NOT FITTED by default. S29AL016J (2 MB) in byte mode: BYTE# low, PIO A0 on DQ15/A-1, PIO A1-A20 on flash A0-A19, so flash byte address = PIO byte address and the unlock cycles land at BIOS offsets 0xAAA/0x555. /CE = /CS2, /OE = /RD, /WE = /WR0, D0-D7 shared with the FX3. No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
