rixnobis/ps1-fx3-cart/ps1-fx3-cart.kicad_pcb

## KiCad design ps1-fx3-cart.kicad_pcb (continued)

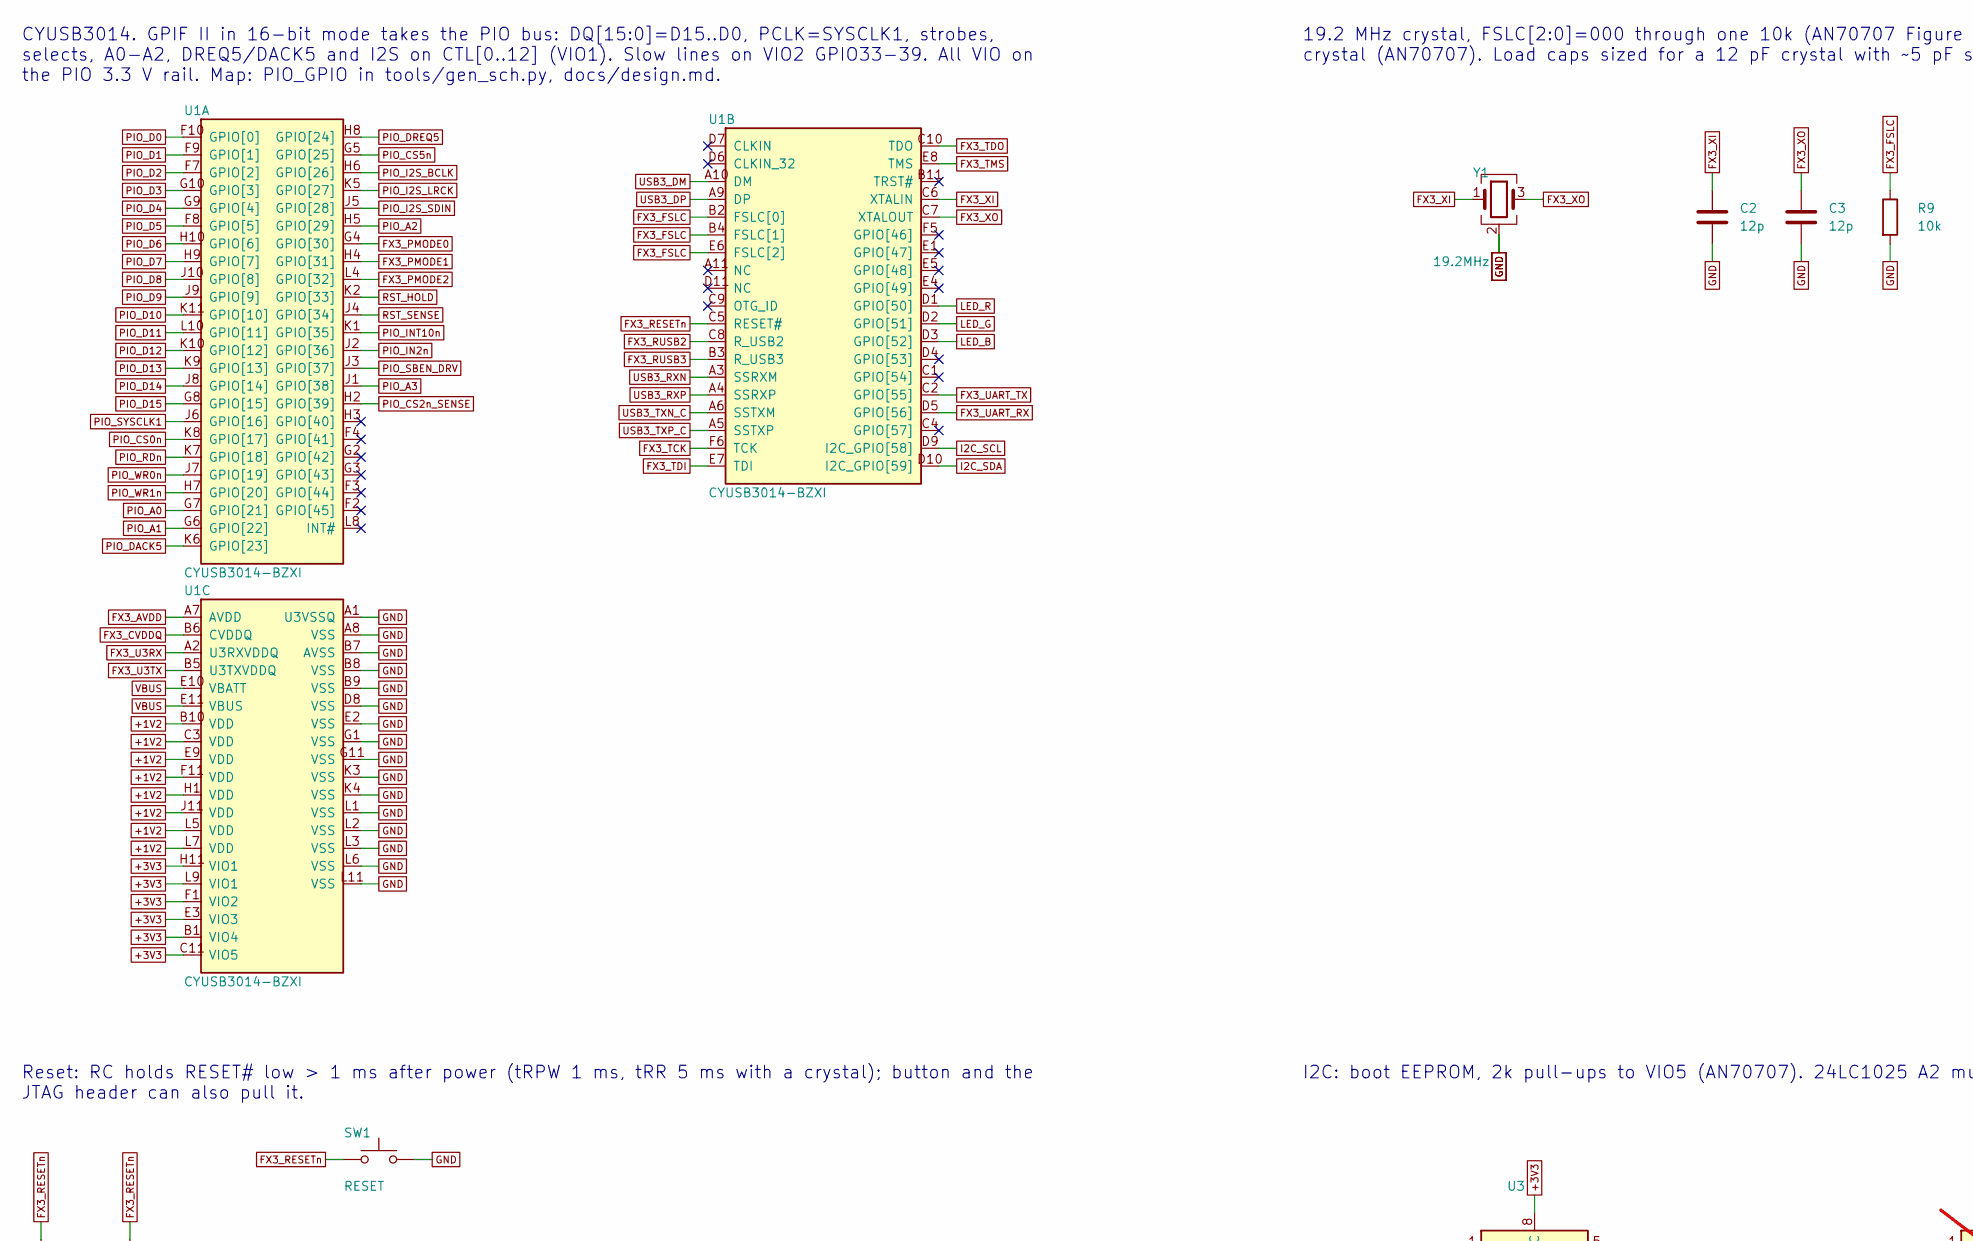
[picture p9: schematic fx3.kicad_sch, FX3 USB 3 bridge, part in row 1, column 1]

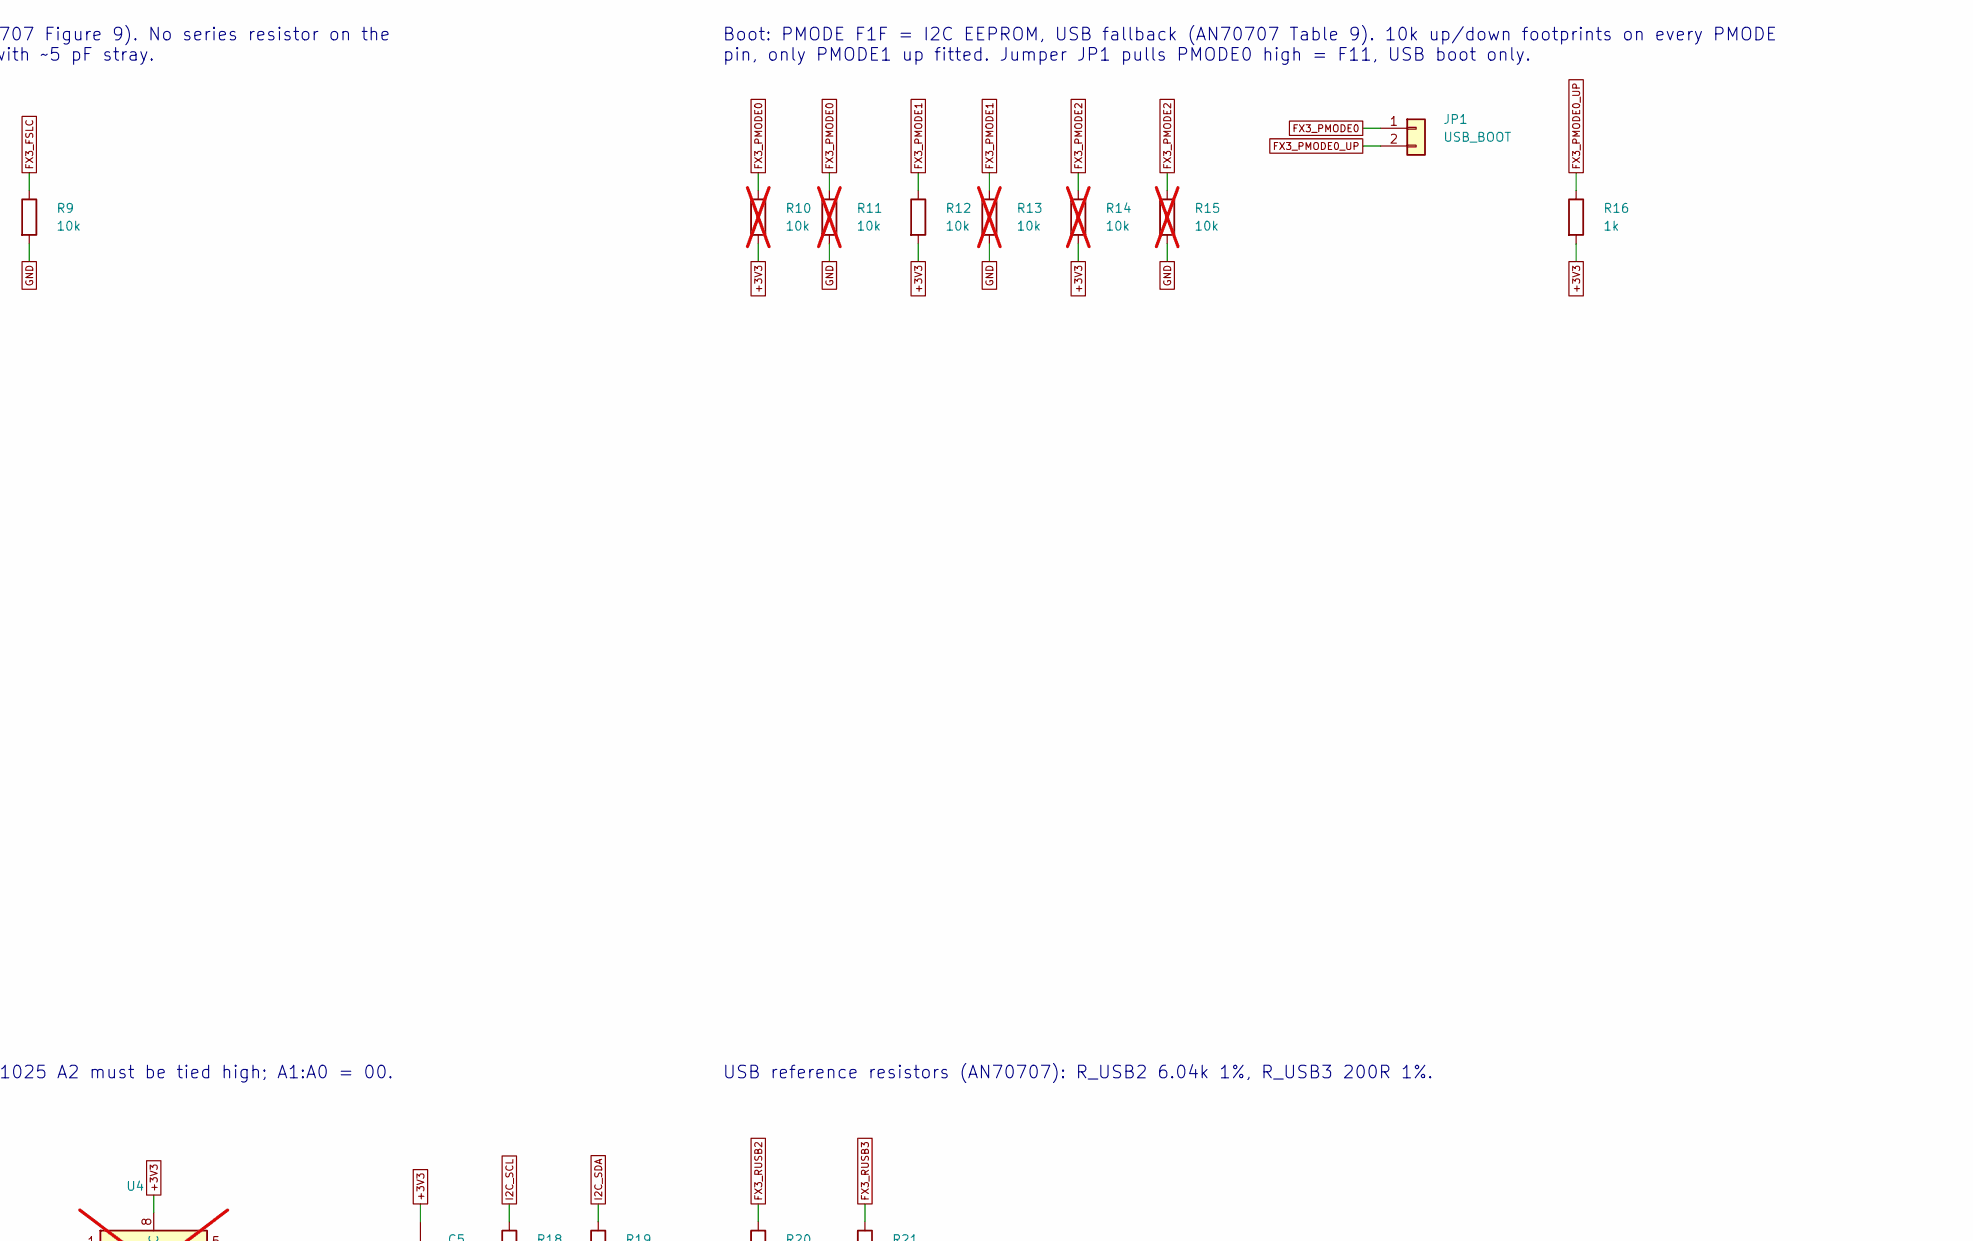
[picture p10: schematic fx3.kicad_sch, FX3 USB 3 bridge, part in row 1, column 2]

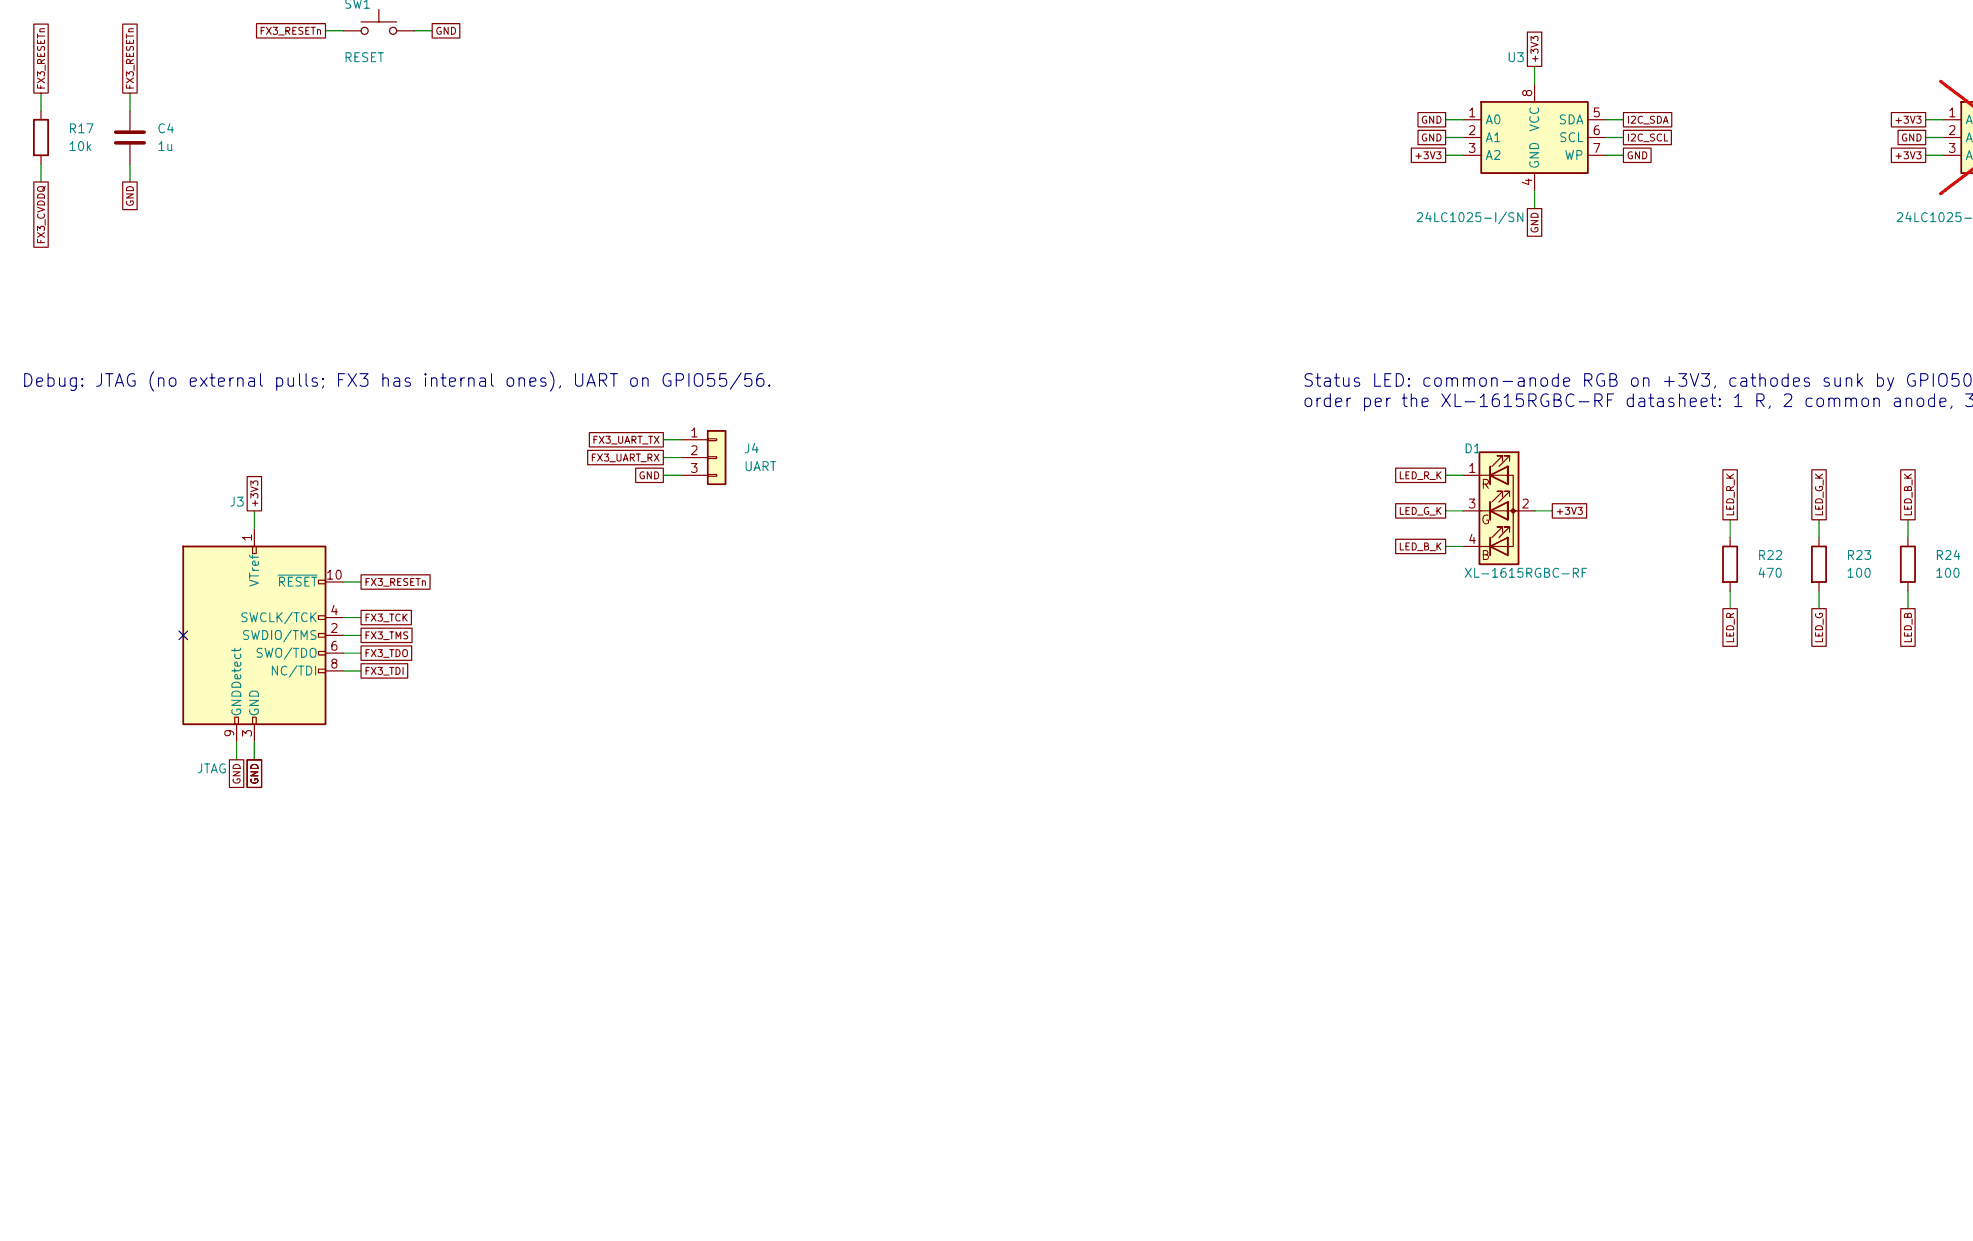
[picture p11: schematic fx3.kicad_sch, FX3 USB 3 bridge, part in row 2, column 1]

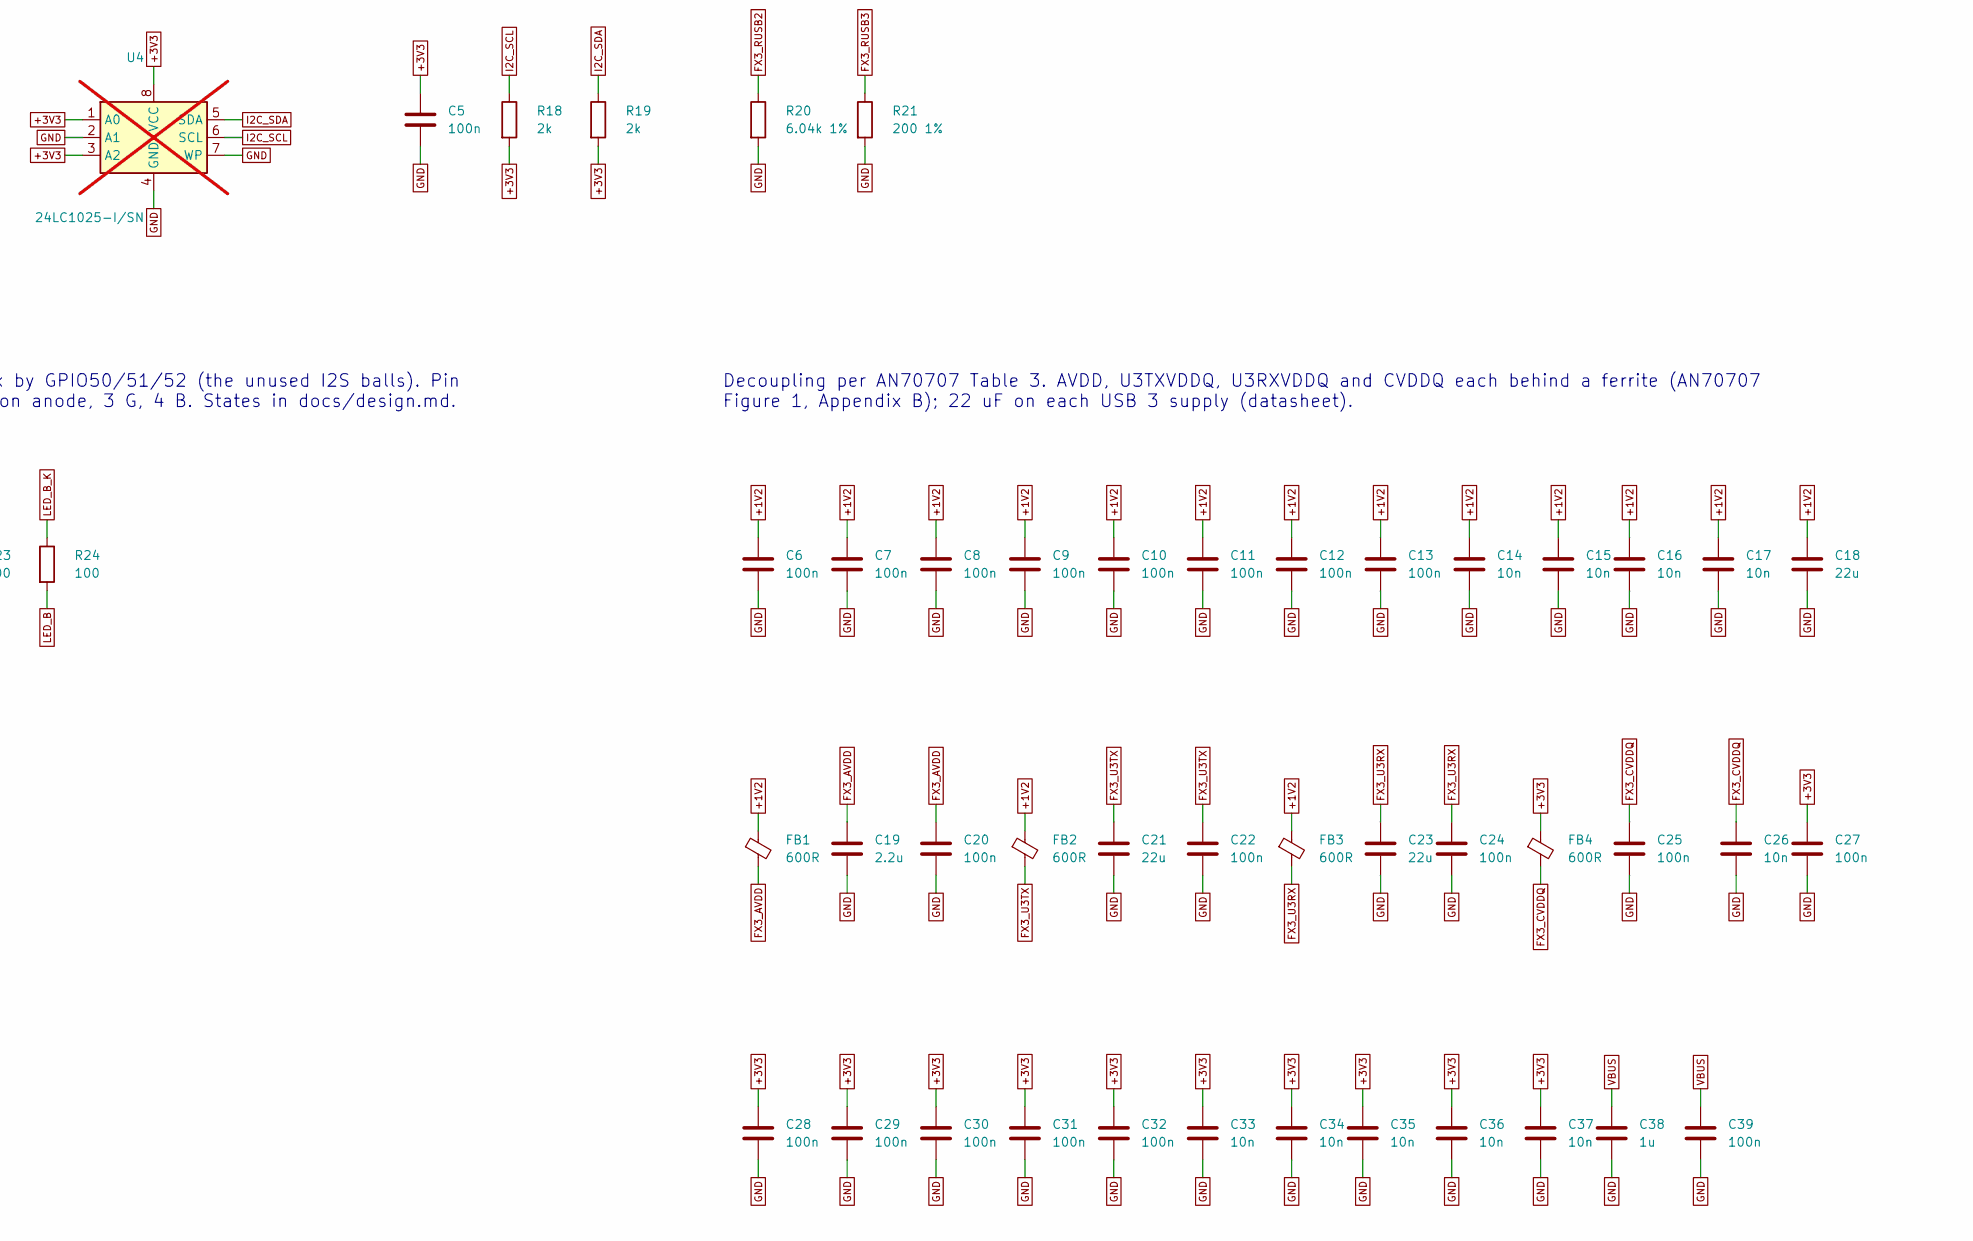
[picture p12: schematic fx3.kicad_sch, FX3 USB 3 bridge, part in row 2, column 2]

Parts:
C2, C3: 12p; C_0402_1005Metric; LCSC C1547
C4, C38: 1u; C_0402_1005Metric; LCSC C52923
C5, C6, C7, C8, C9, C10, C11, C12, C13, C20, C22, C24, C25, C27, C28, C29, C30, C31, C32, C39: 100n; C_0402_1005Metric; LCSC C1525
C14, C15, C16, C17, C26, C33, C34, C35, C36, C37: 10n; C_0402_1005Metric; LCSC C15195
C18, C21, C23: 22u; C_0805_2012Metric; LCSC C45783
C19: 2.2u; C_0603_1608Metric; LCSC C23630
D1: XL-1615RGBC-RF; LED-ARRAY-SMD_4P-L1.6-W1.5-BR_XL-1615RGBC-RF; LCSC C965840
FB1, FB2, FB3, FB4: 600R; L_0603_1608Metric; LCSC C108301
J3: JTAG; PinHeader_2x05_P1.27mm_Vertical_SMD
J4: UART; PinHeader_1x03_P2.54mm_Vertical
JP1: USB_BOOT; PinHeader_1x02_P2.54mm_Vertical
R9, R12, R17: 10k; R_0402_1005Metric; LCSC C25744
R10, R11, R13, R14, R15: 10k; R_0402_1005Metric; LCSC C25744; not fitted
R16: 1k; R_0402_1005Metric; LCSC C11702
R18, R19: 2k; R_0402_1005Metric; LCSC C4109
R20: 6.04k 1%; R_0402_1005Metric; LCSC C97819
R21: 200 1%; R_0402_1005Metric; LCSC C25087
R22: 470; R_0402_1005Metric; LCSC C25117
R23, R24: 100; R_0402_1005Metric; LCSC C25076
SW1: RESET; SW_SPST_TL3342; LCSC C318884
U1: CYUSB3014-BZXI; BGA-121_L10.0-W10.0-R11-C11-P0.80-TL; LCSC C57294
U3: 24LC1025-I/SN; SOIC-8_3.9x4.9mm_P1.27mm; LCSC C615697
U4: 24LC1025-I/SN; SOIC-8_3.9x4.9mm_P1.27mm; LCSC C615697; not fitted
Y1: 19.2MHz; Crystal_SMD_3225-4Pin_3.2x2.5mm; LCSC C411225

Connections:
+1V2: C6.1, C7.1, C8.1, C9.1, C10.1, C11.1, C12.1, C13.1, C14.1, C15.1, C16.1, C17.1, C18.1, FB1.1, FB2.1, FB3.1, U1.B10 (VDD), U1.C3 (VDD), U1.E9 (VDD), U1.F11 (VDD), U1.H1 (VDD), U1.J11 (VDD), U1.L5 (VDD), U1.L7 (VDD); also elsewhere on the board
+3V3: C5.1, C27.1, C28.1, C29.1, C30.1, C31.1, C32.1, C33.1, C34.1, C35.1, C36.1, C37.1, D1.2 (A), FB4.1, J3.1 (VTref), R10.2, R12.2, R14.2, R16.2, R18.2, R19.2, U1.B1 (VIO4), U1.C11 (VIO5), U1.E3 (VIO3), U1.F1 (VIO2), U1.H11 (VIO1), U1.L9 (VIO1), U3.3 (A2), U3.8 (VCC), U4.1 (A0), U4.3 (A2), U4.8 (VCC); also elsewhere on the board
FX3_AVDD: C19.1, C20.1, FB1.2, U1.A7 (AVDD)
FX3_CVDDQ: C25.1, C26.1, FB4.2, R17.2, U1.B6 (CVDDQ)
FX3_FSLC: R9.1, U1.B2 (FSLC[0]), U1.B4 (FSLC[1]), U1.E6 (FSLC[2])
FX3_PMODE0: JP1.1, R10.1, R11.1, U1.G4 (GPIO[30])
FX3_PMODE0_UP: JP1.2, R16.1
FX3_PMODE1: R12.1, R13.1, U1.H4 (GPIO[31])
FX3_PMODE2: R14.1, R15.1, U1.L4 (GPIO[32])
FX3_RESETn: C4.1, J3.10 (~RESET), R17.1, SW1.1, U1.C5 (RESET#)
FX3_RUSB2: R20.1, U1.C8 (R_USB2)
FX3_RUSB3: R21.1, U1.B3 (R_USB3)
FX3_TCK: J3.4 (SWCLK/TCK), U1.F6 (TCK)
FX3_TDI: J3.8 (NC/TDI), U1.E7 (TDI)
FX3_TDO: J3.6 (SWO/TDO), U1.C10 (TDO)
FX3_TMS: J3.2 (SWDIO/TMS), U1.E8 (TMS)
FX3_U3RX: C23.1, C24.1, FB3.2, U1.A2 (U3RXVDDQ)
FX3_U3TX: C21.1, C22.1, FB2.2, U1.B5 (U3TXVDDQ)
FX3_UART_RX: J4.2, U1.D5 (GPIO[56])
FX3_UART_TX: J4.1, U1.C2 (GPIO[55])
FX3_XI: C2.1, U1.C6 (XTALIN), Y1.1
FX3_XO: C3.1, U1.C7 (XTALOUT), Y1.3
GND: C2.2, C3.2, C4.2, C5.2, C6.2, C7.2, C8.2, C9.2, C10.2, C11.2, C12.2, C13.2, C14.2, C15.2, C16.2, C17.2, C18.2, C19.2, C20.2, C21.2, C22.2, C23.2, C24.2, C25.2, C26.2, C27.2, C28.2, C29.2, C30.2, C31.2, C32.2, C33.2, C34.2, C35.2, C36.2, C37.2, C38.2, C39.2, J3.3 (GND), J3.5 (GND), J3.9 (GNDDetect), J4.3, R9.2, R11.2, R13.2, R15.2, R20.2, R21.2, SW1.2, U1.A1 (U3VSSQ), U1.A8 (VSS), U1.B7 (AVSS), U1.B8 (VSS), U1.B9 (VSS), U1.D8 (VSS), U1.E2 (VSS), U1.G1 (VSS), U1.G11 (VSS), U1.K3 (VSS), U1.K4 (VSS), U1.L1 (VSS), U1.L2 (VSS), U1.L3 (VSS), U1.L6 (VSS), U1.L11 (VSS), U3.1 (A0), U3.2 (A1), U3.4 (GND), U3.7 (WP), U4.2 (A1), U4.4 (GND), U4.7 (WP), Y1.2 (G), Y1.4 (G); also elsewhere on the board
I2C_SCL: R18.1, U1.D9 (I2C_GPIO[58]), U3.6 (SCL), U4.6 (SCL)
I2C_SDA: R19.1, U1.D10 (I2C_GPIO[59]), U3.5 (SDA), U4.5 (SDA)
LED_B: R24.2, U1.D3 (GPIO[52])
LED_B_K: D1.4 (BK), R24.1
LED_G: R23.2, U1.D2 (GPIO[51])
LED_G_K: D1.3 (GK), R23.1
LED_R: R22.2, U1.D1 (GPIO[50])
LED_R_K: D1.1 (RK), R22.1
PIO_A0: U1.G7 (GPIO[21]); also elsewhere on the board
PIO_A1: U1.G6 (GPIO[22]); also elsewhere on the board
PIO_A2: U1.H5 (GPIO[29]); also elsewhere on the board
PIO_A3: U1.J1 (GPIO[38]); also elsewhere on the board
PIO_CS0n: U1.K8 (GPIO[17]); also elsewhere on the board
PIO_CS2n_SENSE: U1.H2 (GPIO[39]); also elsewhere on the board
PIO_CS5n: U1.G5 (GPIO[25]); also elsewhere on the board
PIO_D0: U1.F10 (GPIO[0]); also elsewhere on the board
PIO_D1: U1.F9 (GPIO[1]); also elsewhere on the board
PIO_D2: U1.F7 (GPIO[2]); also elsewhere on the board
PIO_D3: U1.G10 (GPIO[3]); also elsewhere on the board
PIO_D4: U1.G9 (GPIO[4]); also elsewhere on the board
PIO_D5: U1.F8 (GPIO[5]); also elsewhere on the board
PIO_D6: U1.H10 (GPIO[6]); also elsewhere on the board
PIO_D7: U1.H9 (GPIO[7]); also elsewhere on the board
PIO_D8: U1.J10 (GPIO[8]); also elsewhere on the board
PIO_D9: U1.J9 (GPIO[9]); also elsewhere on the board
PIO_D10: U1.K11 (GPIO[10]); also elsewhere on the board
PIO_D11: U1.L10 (GPIO[11]); also elsewhere on the board
PIO_D12: U1.K10 (GPIO[12]); also elsewhere on the board
PIO_D13: U1.K9 (GPIO[13]); also elsewhere on the board
PIO_D14: U1.J8 (GPIO[14]); also elsewhere on the board
PIO_D15: U1.G8 (GPIO[15]); also elsewhere on the board
PIO_DACK5: U1.K6 (GPIO[23]); also elsewhere on the board
PIO_DREQ5: U1.H8 (GPIO[24]); also elsewhere on the board
PIO_I2S_BCLK: U1.H6 (GPIO[26]); also elsewhere on the board
PIO_I2S_LRCK: U1.K5 (GPIO[27]); also elsewhere on the board
PIO_I2S_SDIN: U1.J5 (GPIO[28]); also elsewhere on the board
PIO_IN2n: U1.J2 (GPIO[36]); also elsewhere on the board
PIO_INT10n: U1.K1 (GPIO[35]); also elsewhere on the board
PIO_RDn: U1.K7 (GPIO[18]); also elsewhere on the board
PIO_SBEN_DRV: U1.J3 (GPIO[37]); also elsewhere on the board
PIO_SYSCLK1: U1.J6 (GPIO[16]); also elsewhere on the board
PIO_WR0n: U1.J7 (GPIO[19]); also elsewhere on the board
PIO_WR1n: U1.H7 (GPIO[20]); also elsewhere on the board
RST_HOLD: U1.K2 (GPIO[33]); also elsewhere on the board
RST_SENSE: U1.J4 (GPIO[34]); also elsewhere on the board
USB3_DM: U1.A10 (DM); also elsewhere on the board
USB3_DP: U1.A9 (DP); also elsewhere on the board
USB3_RXN: U1.A3 (SSRXM); also elsewhere on the board
USB3_RXP: U1.A4 (SSRXP); also elsewhere on the board
USB3_TXN_C: U1.A6 (SSTXM); also elsewhere on the board
USB3_TXP_C: U1.A5 (SSTXP); also elsewhere on the board
VBUS: C38.1, C39.1, U1.E10 (VBATT), U1.E11 (VBUS); also elsewhere on the board

Notes on the sheet:
CYUSB3014. GPIF II in 16-bit mode takes the PIO bus: DQ[15:0]=D15..D0, PCLK=SYSCLK1, strobes, selects, A0-A2, DREQ5/DACK5 and I2S on CTL[0..12] (VIO1). Slow lines on VIO2 GPIO33-39. All VIO on the PIO 3.3 V rail. Map: PIO_GPIO in tools/gen_sch.py, docs/design.md.
19.2 MHz crystal, FSLC[2:0]=000 through one 10k (AN70707 Figure 9). No series resistor on the crystal (AN70707). Load caps sized for a 12 pF crystal with ~5 pF stray.
Boot: PMODE F1F = I2C EEPROM, USB fallback (AN70707 Table 9). 10k up/down footprints on every PMODE pin, only PMODE1 up fitted. Jumper JP1 pulls PMODE0 high = F11, USB boot only.
Reset: RC holds RESET# low > 1 ms after power (tRPW 1 ms, tRR 5 ms with a crystal); button and the JTAG header can also pull it.
I2C: boot EEPROM, 2k pull-ups to VIO5 (AN70707). 24LC1025 A2 must be tied high; A1:A0 = 00.
USB reference resistors (AN70707): R_USB2 6.04k 1%, R_USB3 200R 1%.
Debug: JTAG (no external pulls; FX3 has internal ones), UART on GPIO55/56.
Status LED: common-anode RGB on +3V3, cathodes sunk by GPIO50/51/52 (the unused I2S balls). Pin order per the XL-1615RGBC-RF datasheet: 1 R, 2 common anode, 3 G, 4 B. States in docs/design.md.
Decoupling per AN70707 Table 3. AVDD, U3TXVDDQ, U3RXVDDQ and CVDDQ each behind a ferrite (AN70707 Figure 1, Appendix B); 22 uF on each USB 3 supply (datasheet).

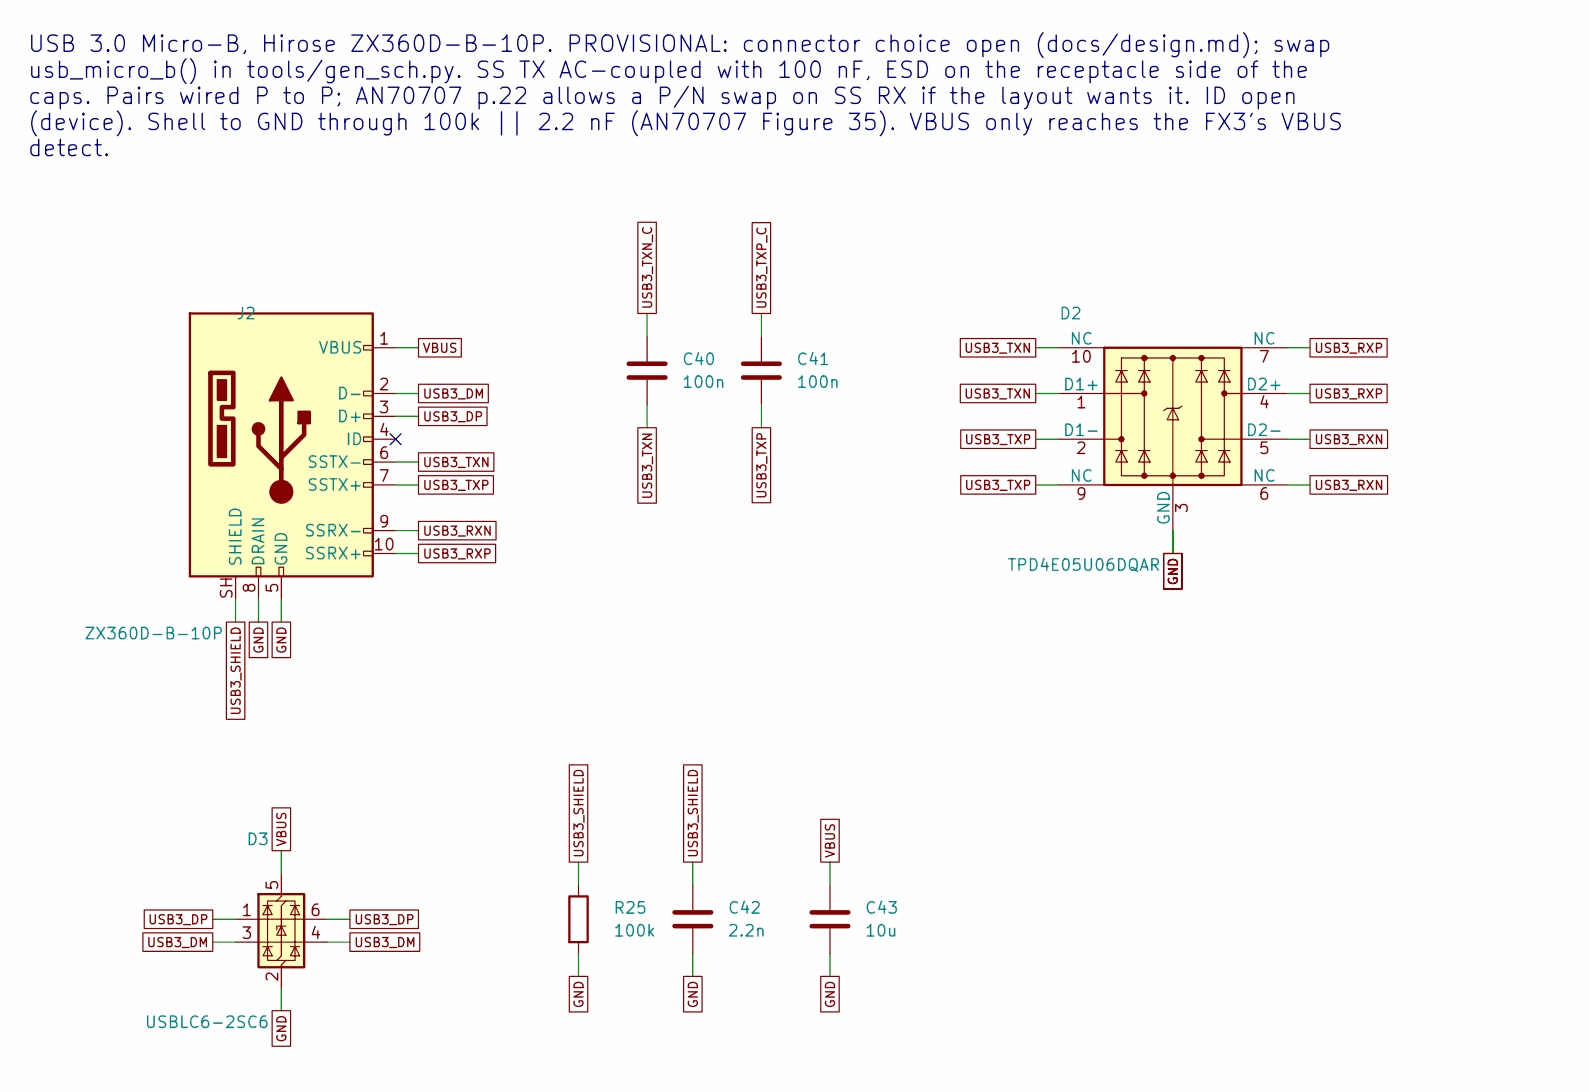
[picture p13: schematic usb.kicad_sch, USB 3 connector (provisional: Micro-B)]

Parts:
C40, C41: 100n; C_0402_1005Metric; LCSC C1525
C42: 2.2n; C_0402_1005Metric; LCSC C1531
C43: 10u; C_0603_1608Metric; LCSC C19702
D2: TPD4E05U06DQAR; USON-10_2.5x1.0mm_P0.5mm; LCSC C138714
D3: USBLC6-2SC6; SOT-23-6; LCSC C7519
J2: ZX360D-B-10P; USB-SMD_ZX360D-B-10P-30; LCSC C598201
R25: 100k; R_0402_1005Metric; LCSC C25741

Connections:
GND: C42.2, C43.2, D2.3 (GND), D2.8 (GND), D3.2 (GND), J2.5 (GND), J2.8 (DRAIN), R25.2; also elsewhere on the board
USB3_DM: D3.3 (I/O2), D3.4 (I/O2), J2.2 (D-); also elsewhere on the board
USB3_DP: D3.1 (I/O1), D3.6 (I/O1), J2.3 (D+); also elsewhere on the board
USB3_RXN: D2.5 (D2-), D2.6 (NC), J2.9 (SSRX-); also elsewhere on the board
USB3_RXP: D2.4 (D2+), D2.7 (NC), J2.10 (SSRX+); also elsewhere on the board
USB3_SHIELD: C42.1, J2.SH (SHIELD), R25.1
USB3_TXN: C40.2, D2.1 (D1+), D2.10 (NC), J2.6 (SSTX-)
USB3_TXN_C: C40.1; also elsewhere on the board
USB3_TXP: C41.2, D2.2 (D1-), D2.9 (NC), J2.7 (SSTX+)
USB3_TXP_C: C41.1; also elsewhere on the board
VBUS: C43.1, D3.5 (VBUS), J2.1 (VBUS); also elsewhere on the board

Notes on the sheet:
USB 3.0 Micro-B, Hirose ZX360D-B-10P. PROVISIONAL: connector choice open (docs/design.md); swap usb_micro_b() in tools/gen_sch.py. SS TX AC-coupled with 100 nF, ESD on the receptacle side of the caps. Pairs wired P to P; AN70707 p.22 allows a P/N swap on SS RX if the layout wants it. ID open (devic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

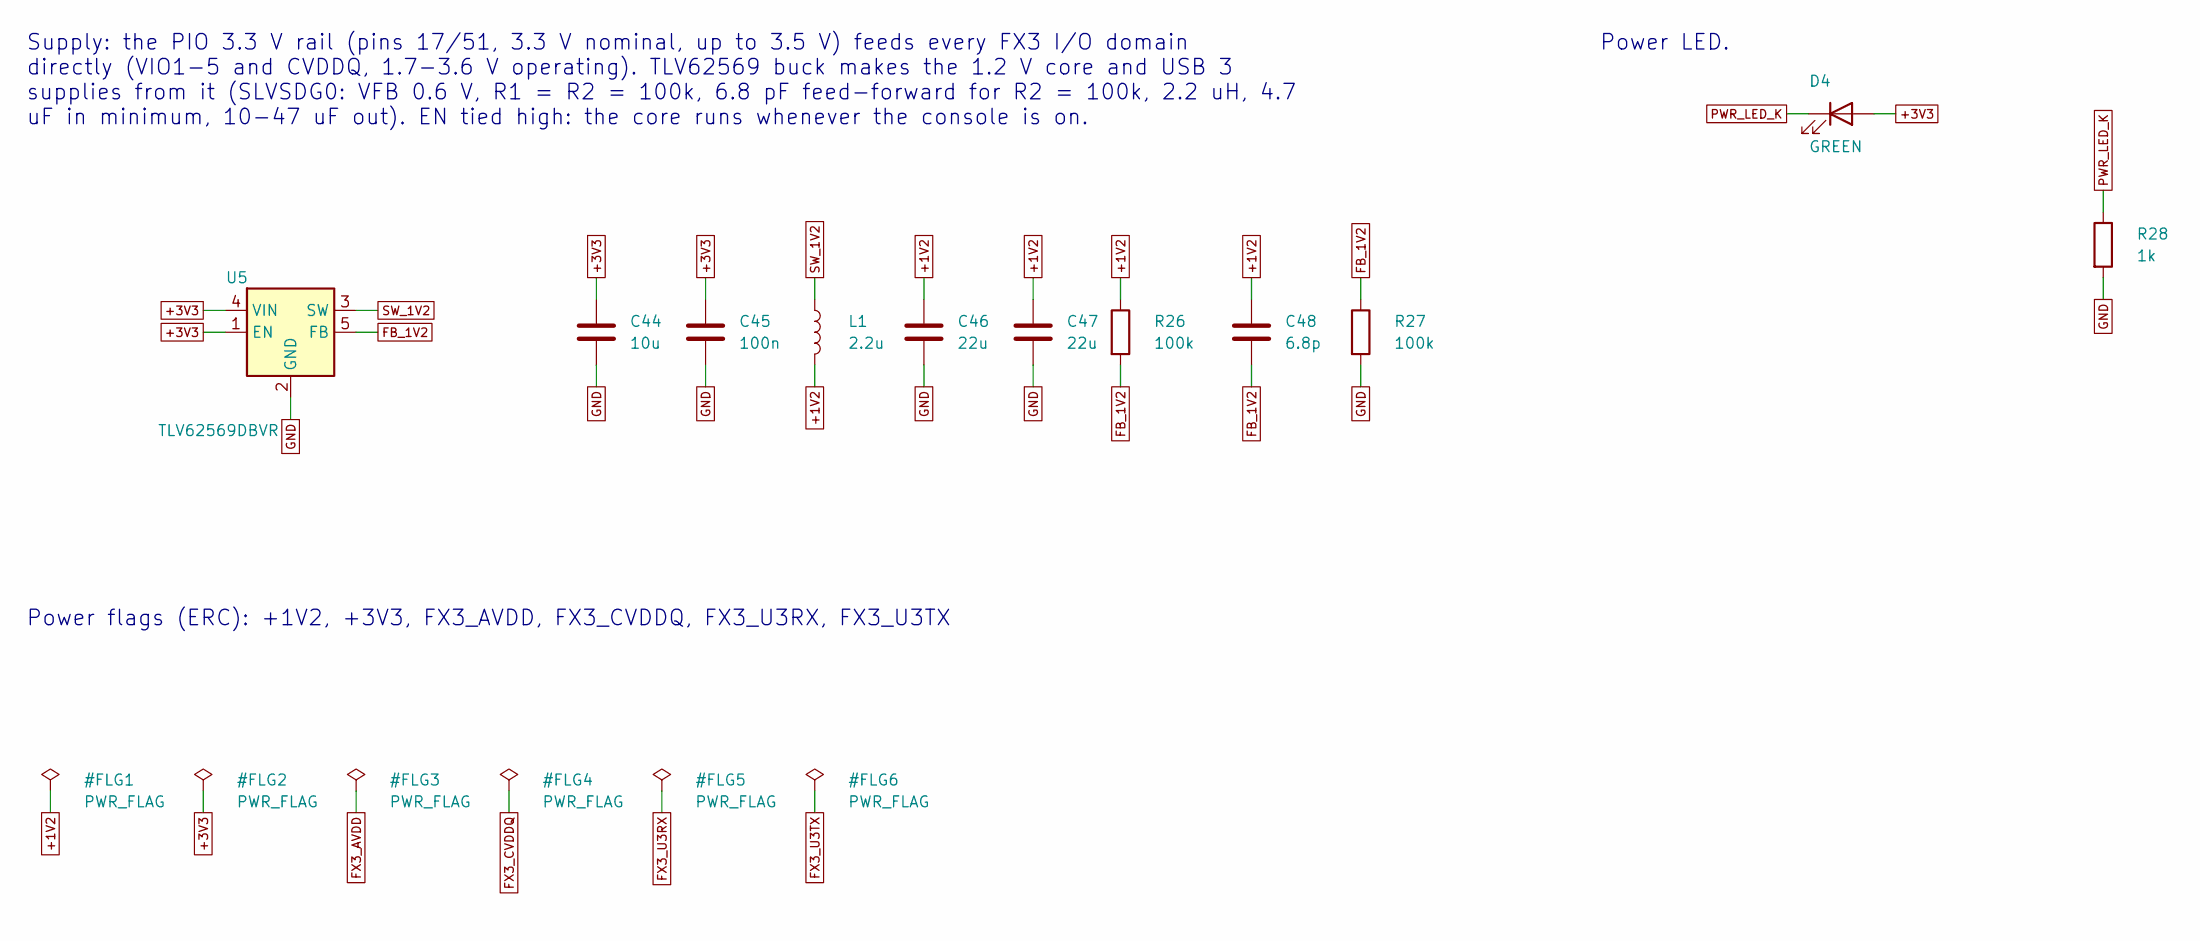
[picture p14: schematic power.kicad_sch, 1.2 V buck from the PIO 3.3 V rail]

Parts:
C44: 10u; C_0603_1608Metric; LCSC C19702
C45: 100n; C_0402_1005Metric; LCSC C1525
C46, C47: 22u; C_0805_2012Metric; LCSC C45783
C48: 6.8p; C_0402_1005Metric; LCSC C1576
D4: GREEN; LED_0603_1608Metric; LCSC C2986059
L1: 2.2u; L_Sunlord_SWPA4030S; LCSC C36409
R26, R27: 100k; R_0402_1005Metric; LCSC C25741
R28: 1k; R_0402_1005Metric; LCSC C11702
U5: TLV62569DBVR; SOT-23-5; LCSC C141836

Connections:
+1V2: C46.1, C47.1, C48.1, L1.2, R26.1; also elsewhere on the board
+3V3: C44.1, C45.1, D4.2 (A), U5.1 (EN), U5.4 (VIN); also elsewhere on the board
FB_1V2: C48.2, R26.2, R27.1, U5.5 (FB)
GND: C44.2, C45.2, C46.2, C47.2, R27.2, R28.2, U5.2 (GND); also elsewhere on the board
PWR_LED_K: D4.1 (K), R28.1
SW_1V2: L1.1, U5.3 (SW)

Notes on the sheet:
Supply: the PIO 3.3 V rail (pins 17/51, 3.3 V nominal, up to 3.5 V) feeds every FX3 I/O domain directly (VIO1-5 and CVDDQ, 1.7-3.6 V operating). TLV62569 buck makes the 1.2 V core and USB 3 supplies from it (SLVSDG0: VFB 0.6 V, R1 = R2 = 100k, 6.8 pF feed-forward for R2 = 100k, 2.2 uH, 4.7 uF in mi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
Power LED.
Power flags (ERC): +1V2, +3V3, FX3_AVDD, FX3_CVDDQ, FX3_U3RX, FX3_U3TX

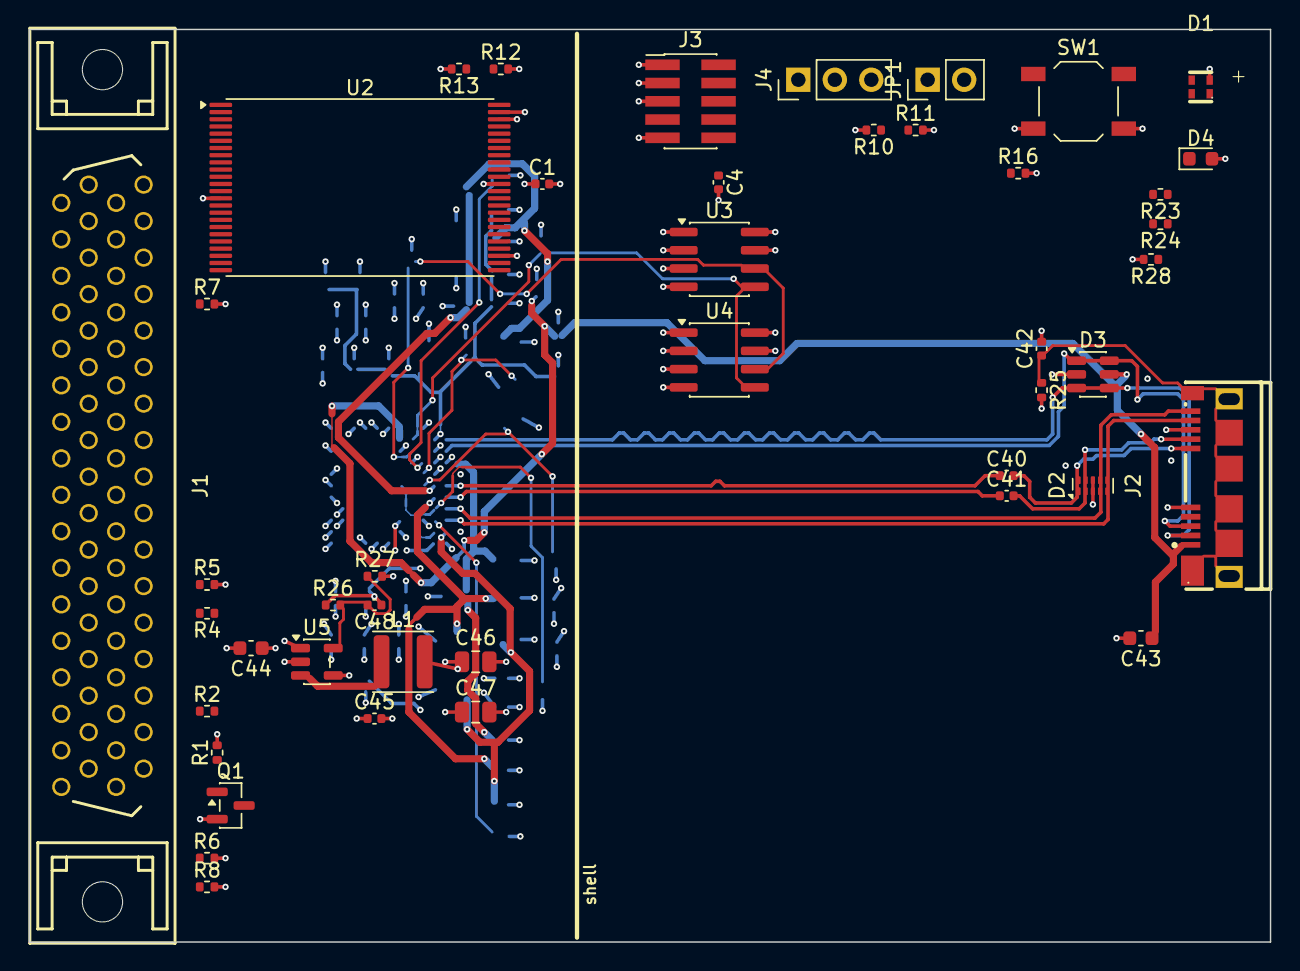
[picture p15: board ps1-fx3-cart.kicad_pcb from above]

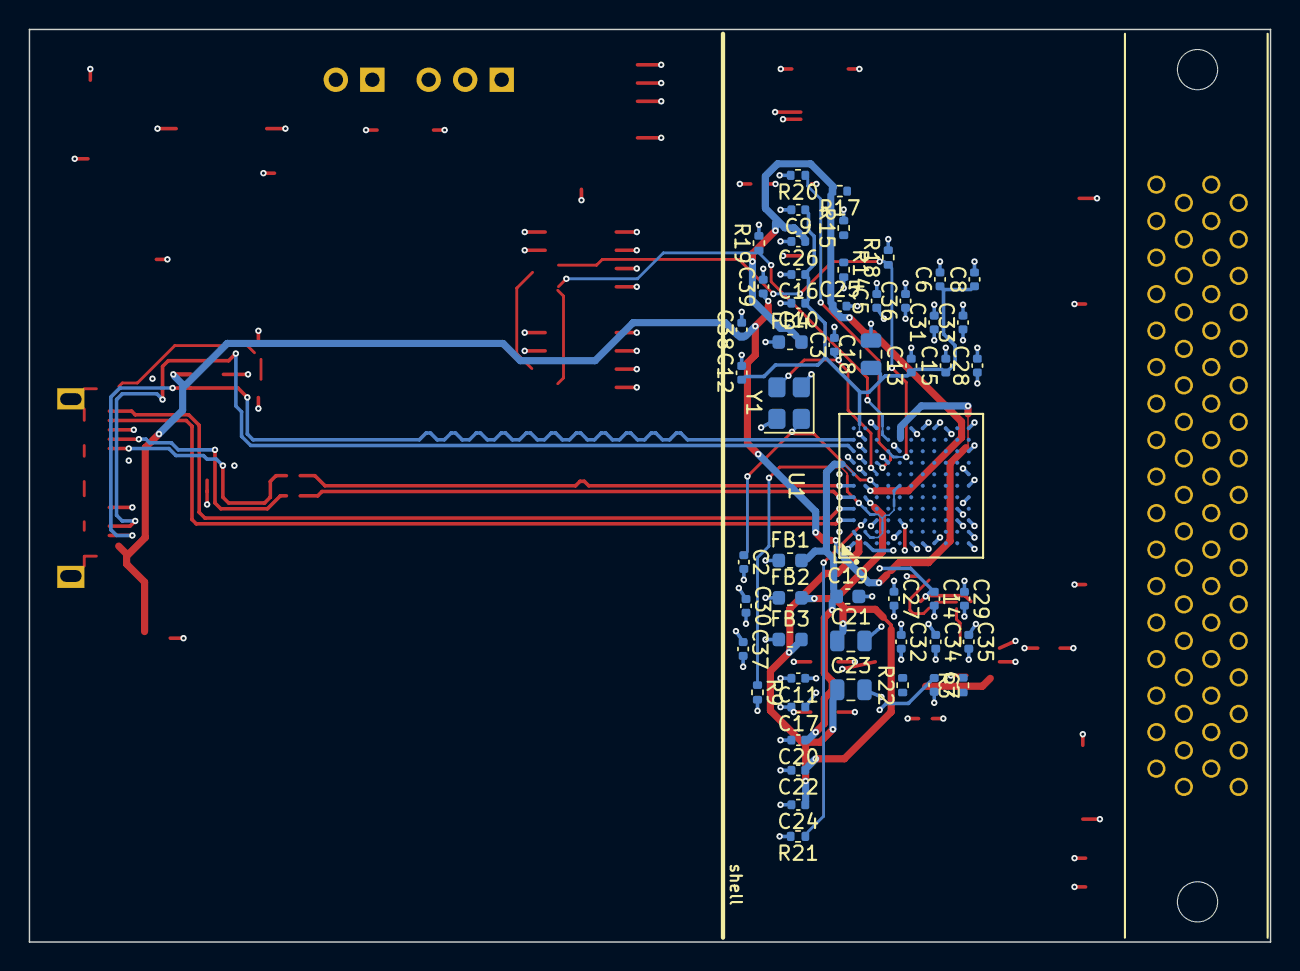
[picture p16: board ps1-fx3-cart.kicad_pcb from below]

Board: 4 copper layers, 86.4 x 63.5 mm, 98 parts (53 on the bottom side), 101 nets.
