rixnobis/ps1-fx3-cart/(commit log)

2026-10-23 Skeleton: FX3 core tooling from ps1-av-capture, design notes
    [fx3.csv]
2026-10-23 FX3 pin map: PIO bus on GPIF II, slow lines on VIO2 GPIO
2026-10-23 design: cart powered from the PIO 3.3 V rail
2026-10-24 design: buck and USB 3 connector candidates, JLC stock
2026-10-24 power sheet: TLV62569 1.2 V buck from the PIO 3.3 V rail
    Replaces ps1-av-capture's three VBUS bucks and TVP7002 LDOs. Values from the
    TLV62569 datasheet: VFB 0.6 V, R1 = R2 = 100k, 6.8 pF feed-forward, 2.2 uH,
    10 uF in, 2 x 22 uF out. The USB connector section stays until the
    connector choice is settled.
    [gen_sch.py]
2026-10-24 PIO connector footprint from the PIOCONN package of pixel.lbr
    tools/eagle_pkg.py converts one EAGLE package (pads, holes, tPlace lines) to
    a KiCad footprint. PIOCONN is the package PIO-Dev-3, PIO-Dev-Lite and
    Pico-Dev all place: 68 pads at 1.27 mm in four staggered rows, two 2.8 mm
    mounting holes.
2026-10-24 gen_sch: drop the capture board's sheets
    Removes the input, TVP7002 and audio sheets, the TVP references on the FX3
    sheet and the USB3 Standard-B section. FX3 becomes U1; the root sheet is
    ps1-fx3-cart.kicad_sch.
2026-10-24 lib: ZX360D-B-10P and XL-1615RGBC footprints
    ZX360D-B-10P is the LCSC C598201 land pattern with the shell pads named SH
    and no 3D model path. The RGB LED pattern is ps1-av-capture's corrected one.
2026-10-24 USB sheet: provisional USB 3.0 Micro-B
    Hirose ZX360D-B-10P, the default while the connector choice is open. It sits
    in usb_micro_b() alone so a USB-C variant replaces one function; the FX3-side
    nets do not change.
    [gen_sch.py]
2026-10-24 PIO sheet: connector, reset hold, default pulls
    68-pin PIO symbol on fx3-cart:PIOCONN, nets per the psx-spx pinout. A 2N7002
    on /RESET with a 1k gate pull-up holds the console until GPIO33 goes low;
    GPIO34 senses /RESET through 1k. SBEN and DREQ5 pulled low, /IRQ10 and /IRQ2
    high. DACK5 loses its n suffix: DREQ/DACK are active high.
    [gen_sch.py]
2026-10-24 Flash sheet: optional S29AL016J BIOS flash, DNP
    TSOP48 in byte mode: BYTE# low, PIO A0 on DQ15/A-1, A1-A20 on A0-A19, D0-D7,
    /CE = /CS2, /OE = /RD, /WE = /WR0. Pin numbers from the S29AL016J TS048
    connection diagram. Not fitted: pin 39 is GND on a stock console.
    [gen_sch.py]
2026-10-24 PIO sheet: GPIO39 senses /CS2 through 1k
    The FX3 net was left dangling. Pin 39 is GND on a stock console, so the series
    resistor turns a misdriven GPIO39 into 3.3 mA instead of a short.
    [gen_sch.py]
2026-10-24 sch_lib: keep reference and value text off the labels
    Headings grow downward from the shelf instead of up past the frame. Parts
    with no right-hand pins get reference and value beside the body, with room
    left for them; text near a top or bottom pin ends left of its label.
2026-10-24 build.sh and a netlist check for the cart
    check_netlist.py now checks the PIO pins against the FX3 balls, the reset hold,
    the default resistors, the flash wiring and the supply pins, from tables written
    out by hand. build.sh chains generation, ERC, the checks and the PDF.
    [check_netlist.py]
2026-10-24 Generated schematic and PDF
    Output of tools/build.sh: ERC clean, netlist, footprint and LCSC checks pass.
    [flash.kicad_sch, fx3.kicad_sch, pio.kicad_sch, power.kicad_sch, ps1-fx3-cart.kicad_sch, usb.kicad_sch]
2026-10-24 PIO sheet: GPIO37 drives SBEN through 1k
    Pin 5 is GND on a stock console, so a GPIO37 driven high sinks 3.3 mA
    instead of shorting it. check_netlist checks the hop like /RESET and /CS2.
    [flash.kicad_sch, fx3.kicad_sch, pio.kicad_sch, power.kicad_sch, ps1-fx3-cart.kicad_sch, usb.kicad_sch]
2026-10-24 lib: ZX360D-B-10P land pattern to Hirose drawing, courtyard around all pads
    Per the Hirose ZX360D-B-10P drawing (EDC-127028-30-00, PCB layout): signal pad 1/5 positions, mid shell pad offsets, through-hole land width and slot size corrected. Courtyard now encloses pads and body with 0.25 mm margin.
2026-10-24 PCB: PIO-Dev-3 outline, shell line and part placement
    tools/build_pcb.py place builds the 4-layer board from the netlist: J1 holes as on PIO-Dev-3,
    FX3 and its decoupling on the back inside the flat zone, flash, buck, debug and USB on the front.
    [ps1-fx3-cart.kicad_pcb]
2026-10-24 build_pcb: J1 comment states the hole-map reasoning, body face as assumed
2026-10-28 Route planes, supplies, USB, crystal and I2C; J1 nets left open
    route_usb.py builds In1 GND and In2 +3V3 with a +1V2 island under the FX3, then
    routes the SS and HS pairs on the 90 ohm class (skew 0.000/0.015/0.000 mm).
    fanout.py and p2p_route.py then do the planes, buck, crystal and EEPROM.
    DRC: copper 0, unconnected 348 -> 105 (74 on J1, 31 JTAG/UART/LED/PMODE/reset).
    [flash.kicad_sch, fx3.kicad_sch, pio.kicad_sch, power.kicad_sch, ps1-fx3-cart.kicad_pcb, ps1-fx3-cart.kicad_sch, usb.kicad_sch]
